smdjeff/pinball-cabin-fever/art/2020/bear.pdf

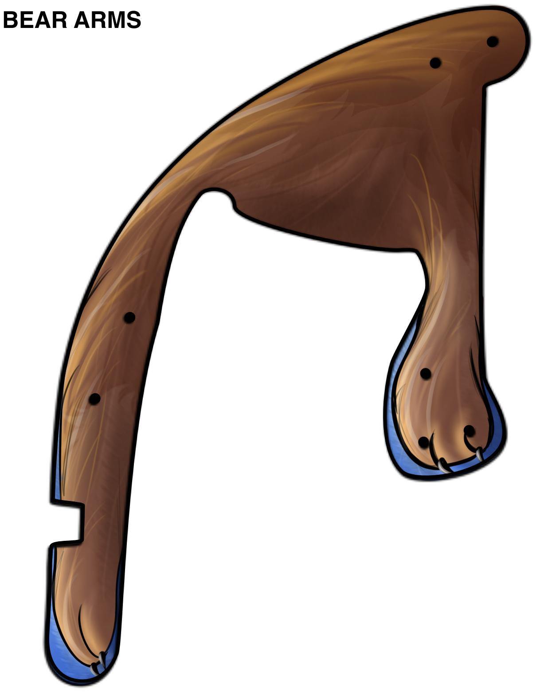
[picture p3: page 1]

BEAR ARMS
