smdjeff/pinball-cabin-fever/art/2020/desert.pdf

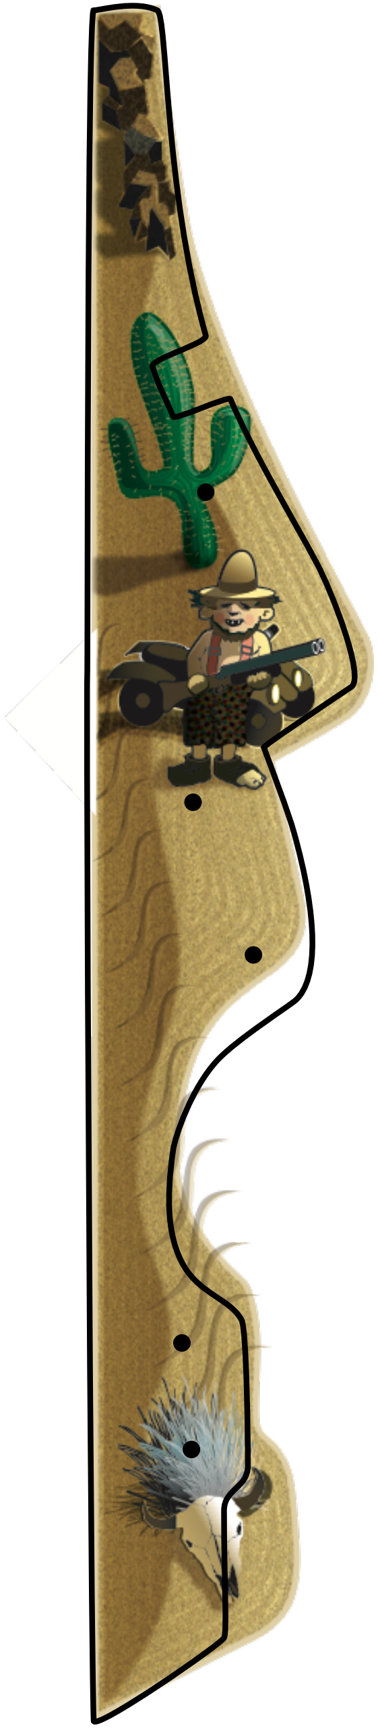
[picture p4: figure]

DESERT
CUTE
CACTUSES
