smdjeff/pinball-cabin-fever/art/2020/forest.pdf

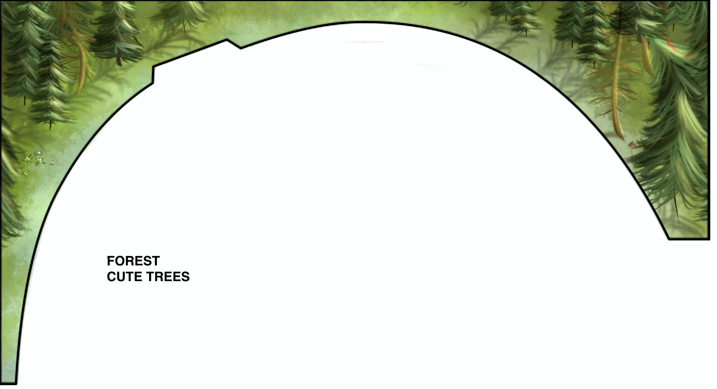
[picture p5: page 1]

FOREST
CUTE TREES
