smdjeff/pinball-cabin-fever/art/2006/bearback.png

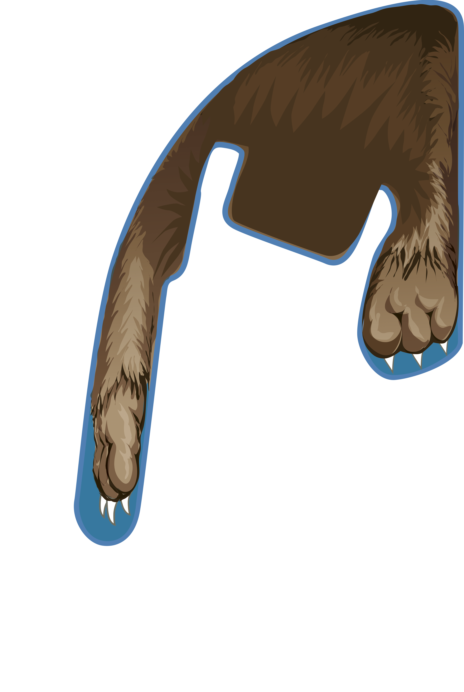
art/2006/bearback.png
