smdjeff/pinball-cabin-fever/art/2006/beavers.png

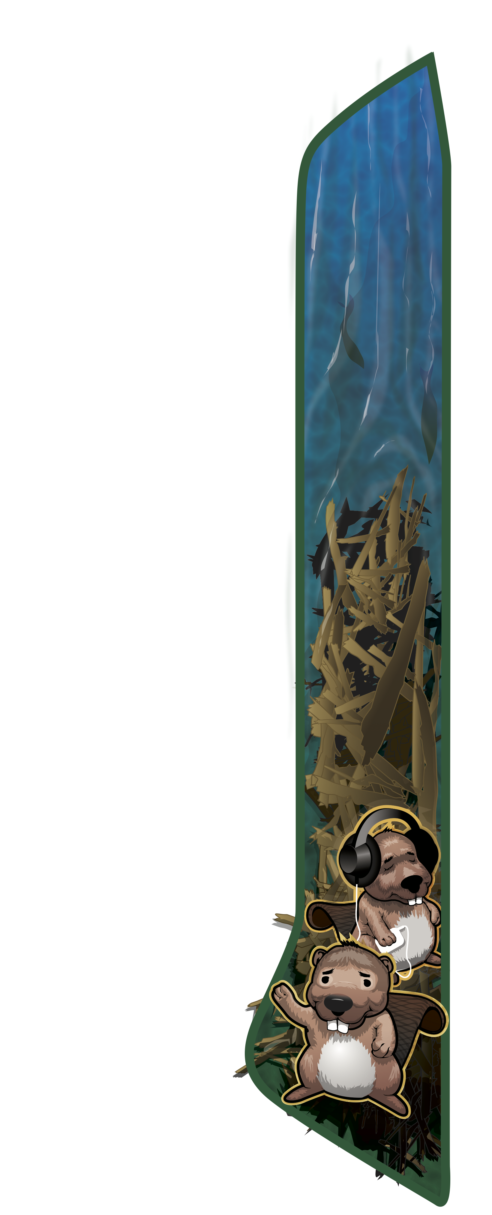
art/2006/beavers.png
