smdjeff/pinball-cabin-fever/art/2006/sling-shot.png

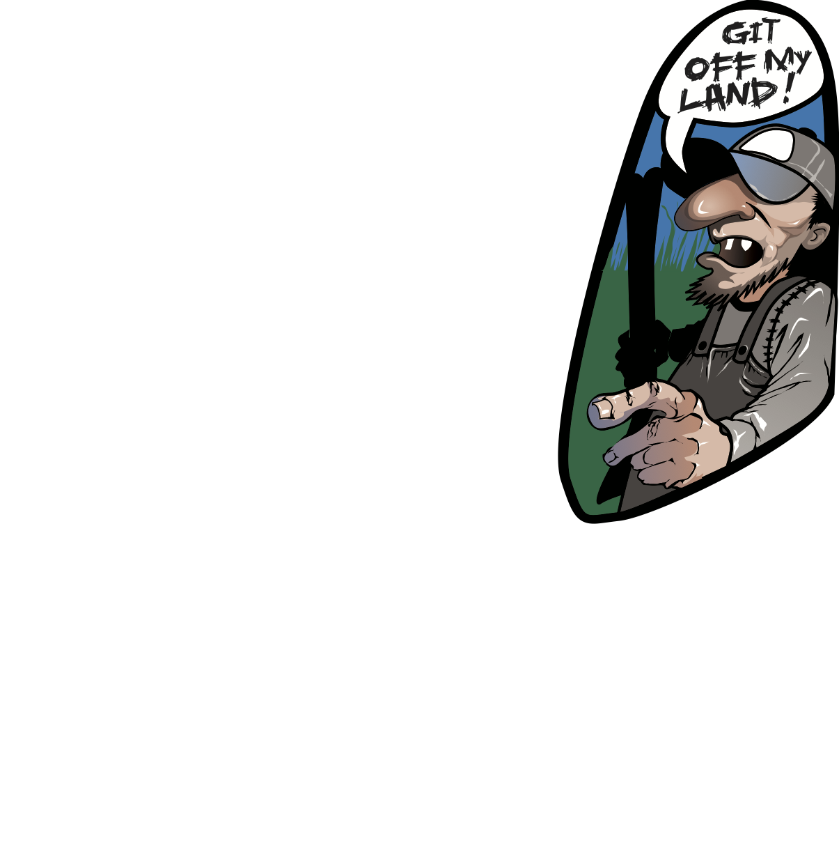
art/2006/sling-shot.png
