smdjeff/pinball-cabin-fever/drawings/P6010001.JPG

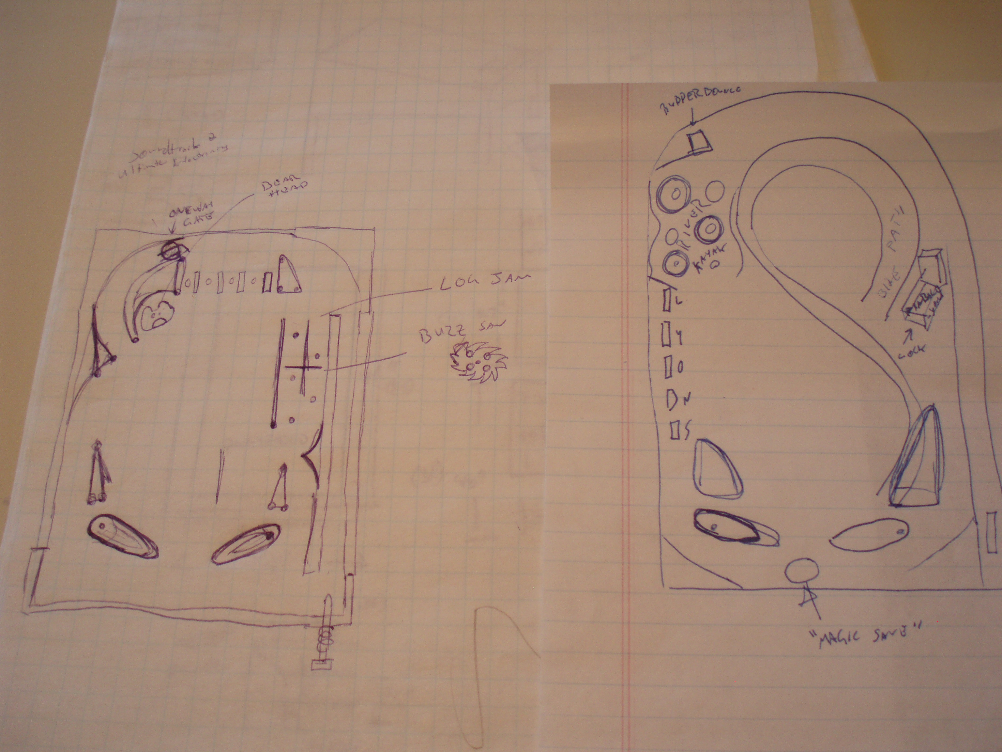
drawings/P6010001.JPG
