smdjeff/pinball-cabin-fever/drawings/P6010002.JPG

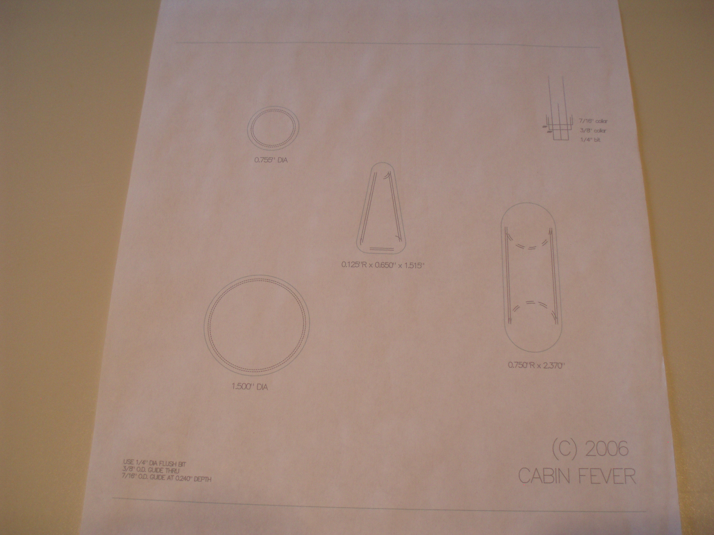
drawings/P6010002.JPG
