smdjeff/pinball-cabin-fever/drawings/P6010003.JPG

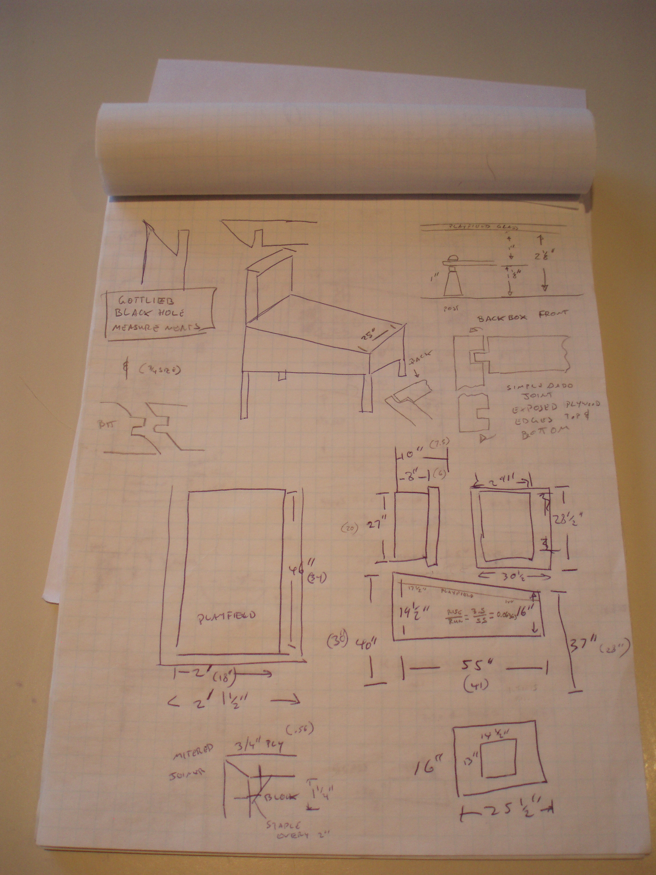
drawings/P6010003.JPG
