smdjeff/pinball-cabin-fever/drawings/P6010004.JPG

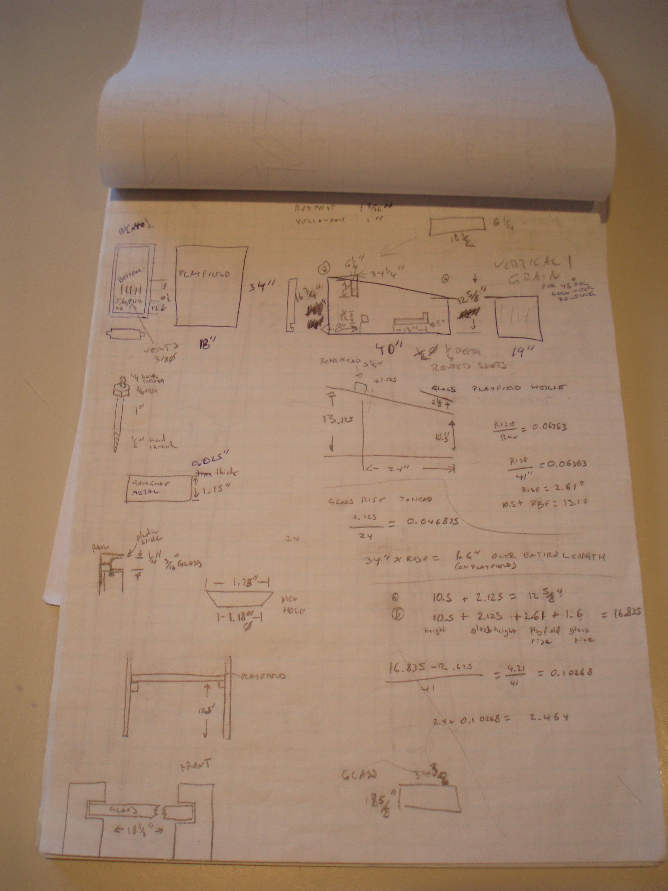
drawings/P6010004.JPG
