smdjeff/pinball-cabin-fever/drawings/P6010005.JPG

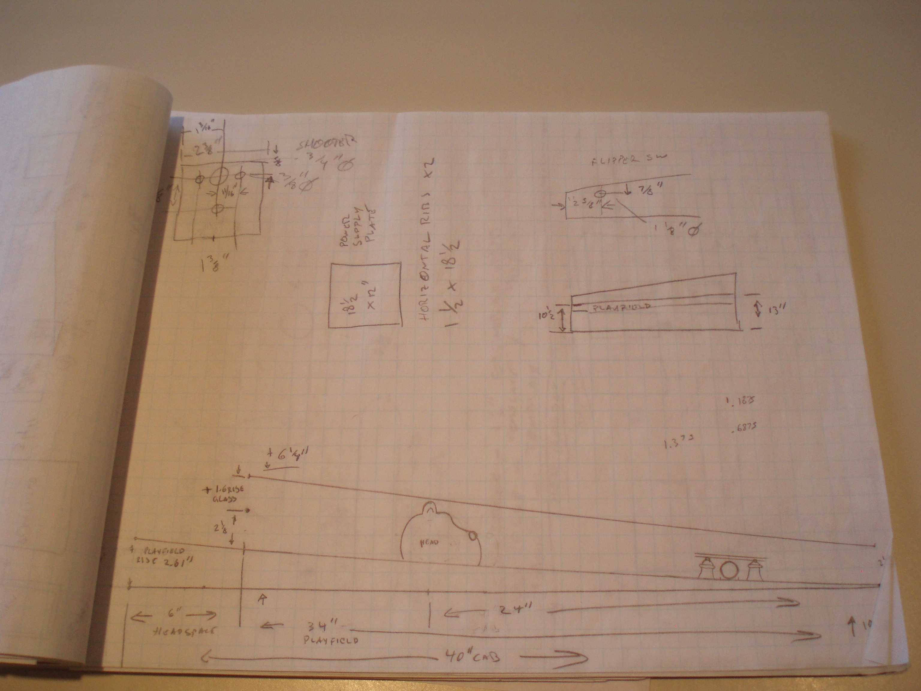
drawings/P6010005.JPG
