smdjeff/pinball-cabin-fever/drawings/P6010006.JPG

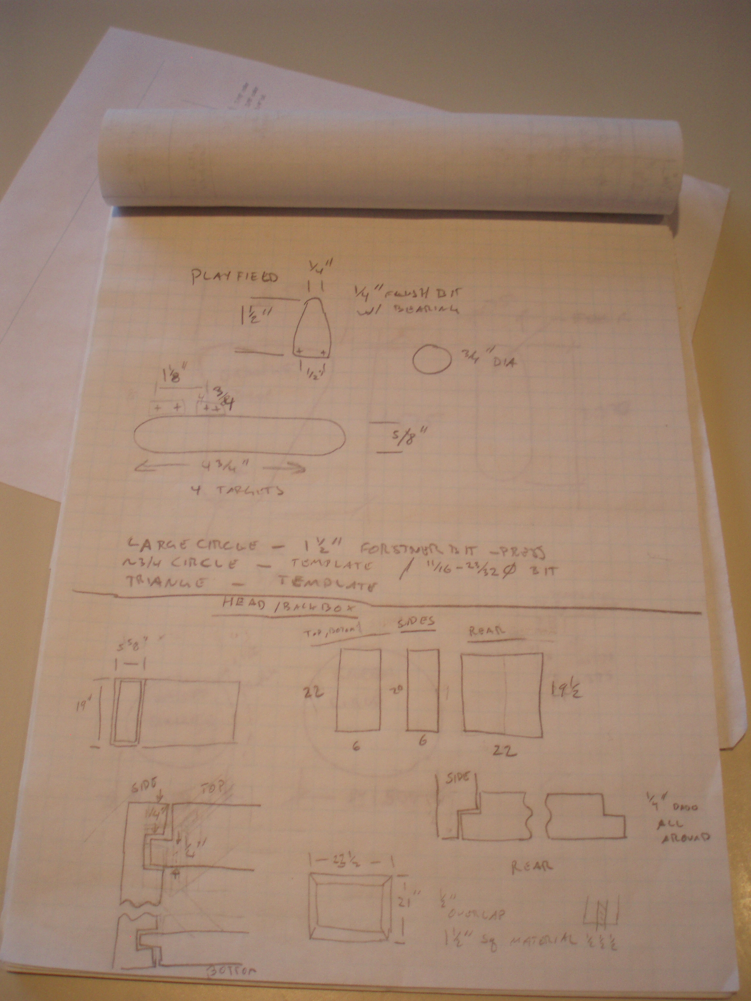
drawings/P6010006.JPG
