smdjeff/pinball-cabin-fever/drawings/P6010007.JPG

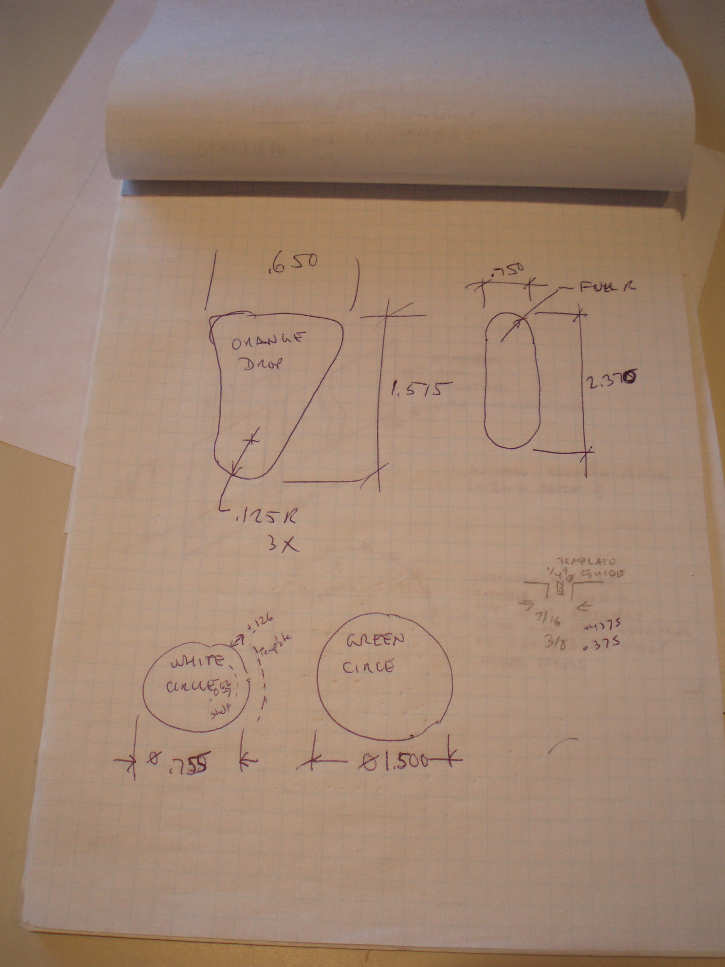
drawings/P6010007.JPG
