smdjeff/pinball-cabin-fever/drawings/P6010008.JPG

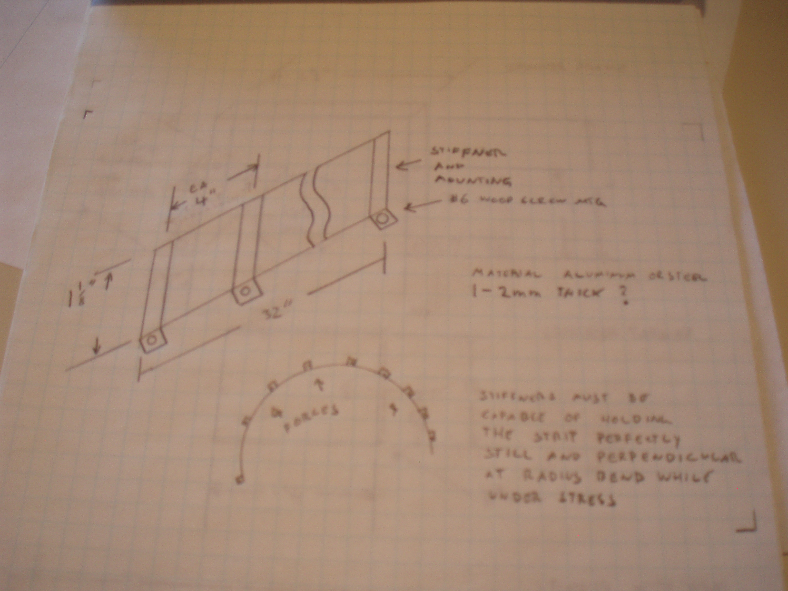
drawings/P6010008.JPG
