smdjeff/pinball-cabin-fever/drawings/P6010009.JPG

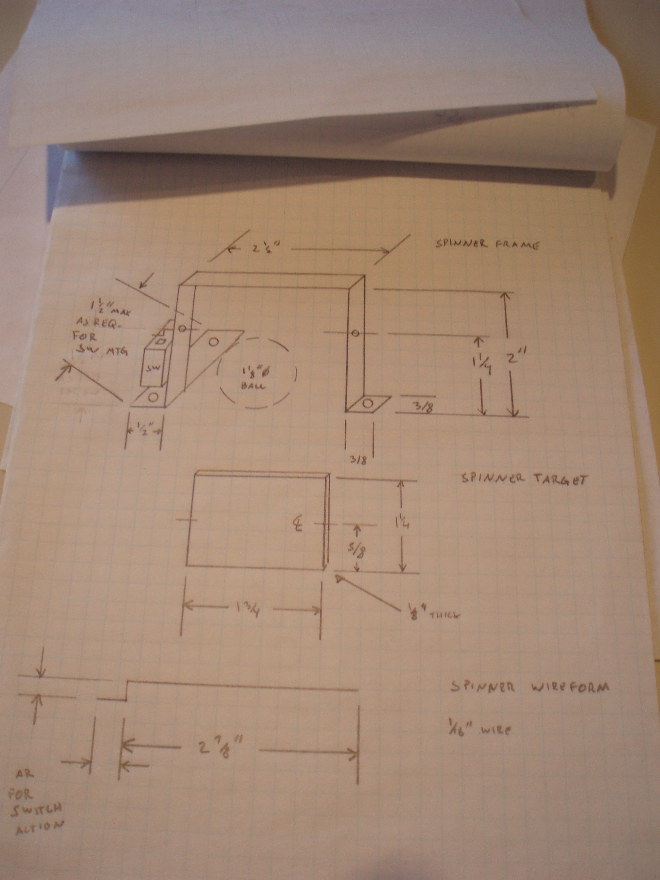
drawings/P6010009.JPG
