smdjeff/pinball-cabin-fever/hardware/PXL_20221127_201824893.jpg

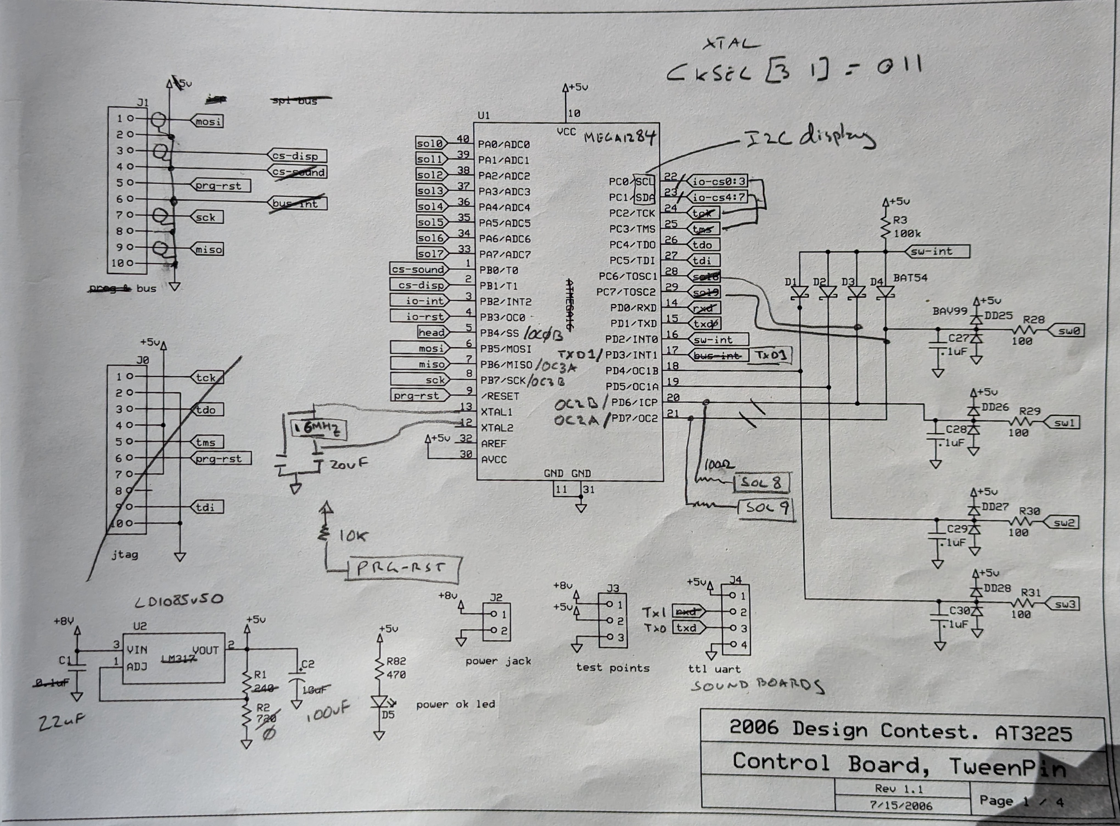
hardware/PXL_20221127_201824893.jpg
