smdjeff/pinball-cabin-fever/(threads)

Thread 2 (2024-12-25):

bug

smdjeff, 2024-12-25:
https://github.com/smdjeff/pinball-cabin-fever/blob/d690e0ed88e16fc53cc86303ee58c6077b1930ee/software/solenoid.c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
