smdjeff/pinball-cabin-fever/hardware/tweenpin-system-diagram.pdf

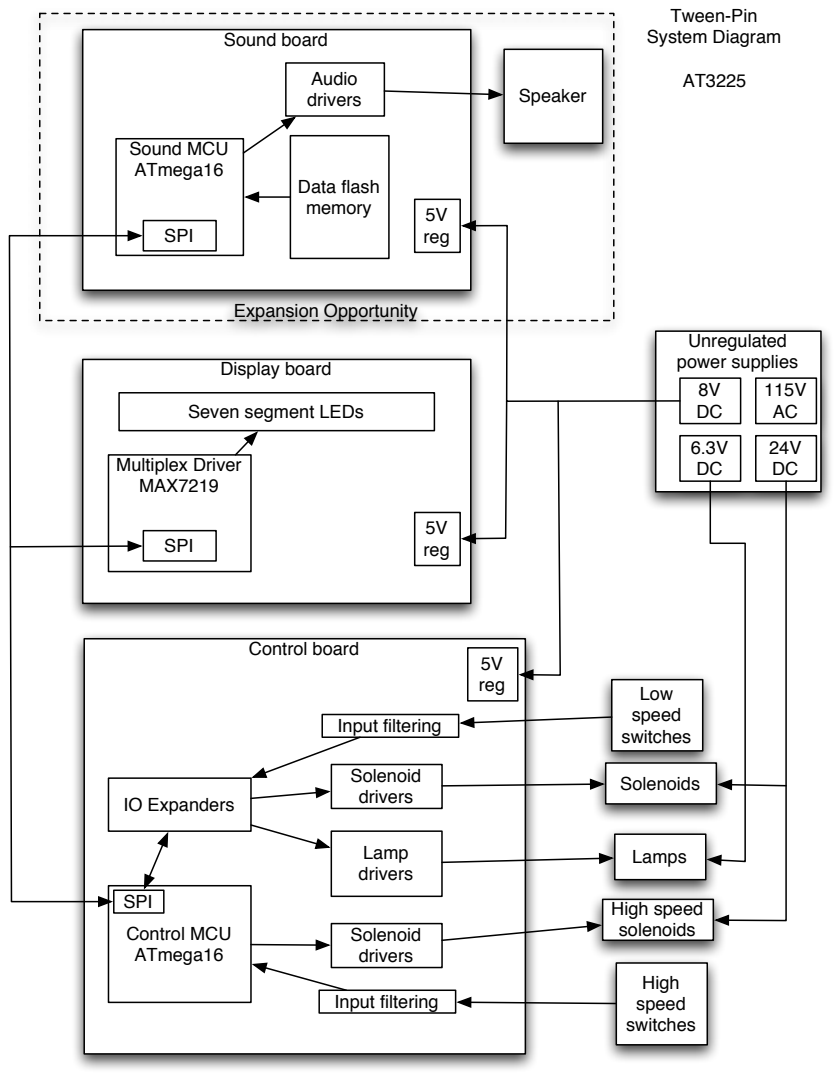
[picture p19: page 1]
Expansion Opportunity; Control board; Unregulated power supplies; Speaker; Solenoids; Lamps; High speed switches; Low speed switches; Sound board; Sound MCU; ATmega16; Data flash; memory; Audio drivers; SPI; 5V reg; Solenoid drivers; Control MCU ATmega16; Lamp drivers; Tween-Pin System Diagram; IO Expanders; Input filtering; High speed; Solenoid; solenoids; drivers; Multiplex Driver MAX7219

Display board

Seven segment LEDs
