smdjeff/pinball-cabin-fever/hardware/tweenpin-control-pcb-bottom.pdf

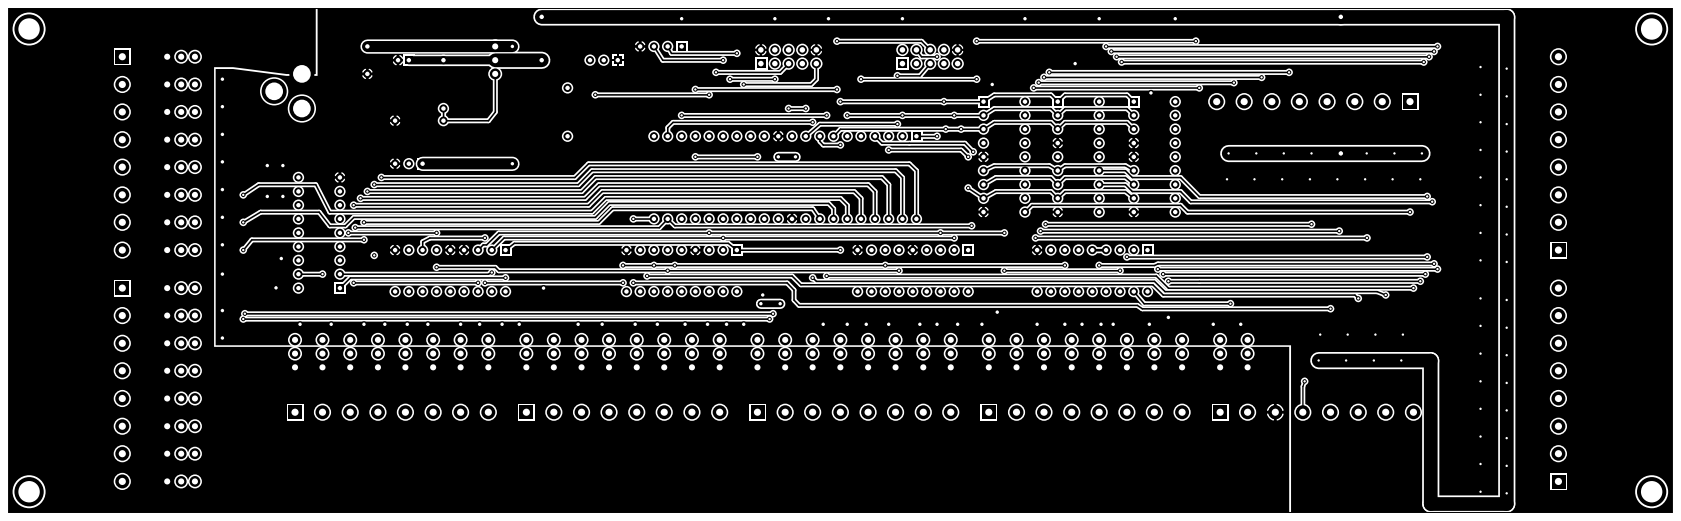
[picture p20: page 1]
