smdjeff/pinball-cabin-fever/hardware/tweenpin-control-pcb-silk.pdf

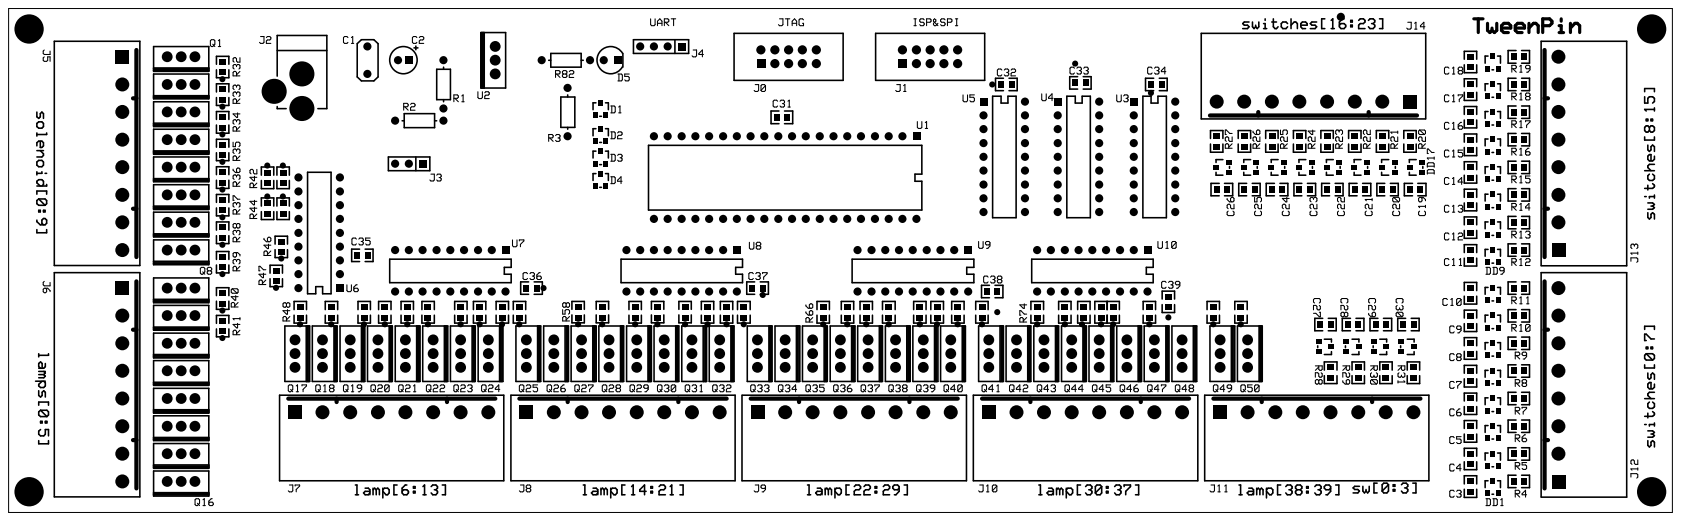
[picture p21: page 1]
