smdjeff/pinball-cabin-fever/hardware/tweenpin-control-pcb-top.pdf

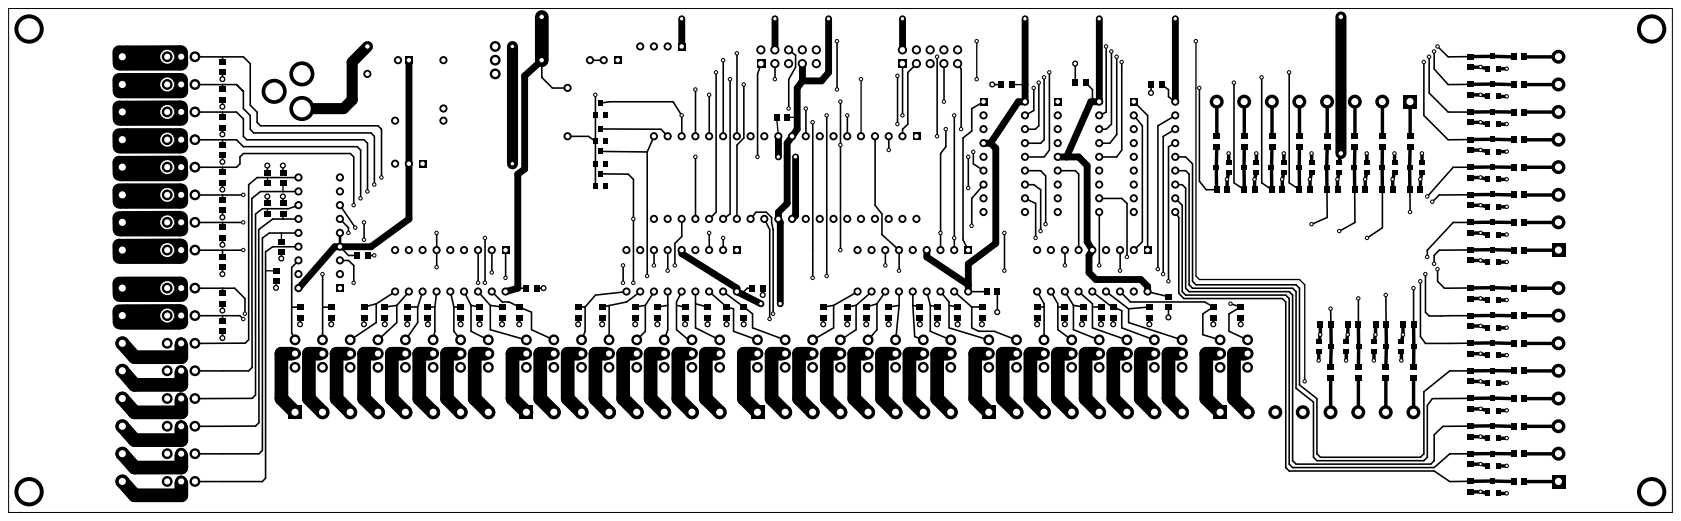
[picture p22: page 1]
