smdjeff/pinball-cabin-fever/hardware/tweenpin-control-sch-1.pdf

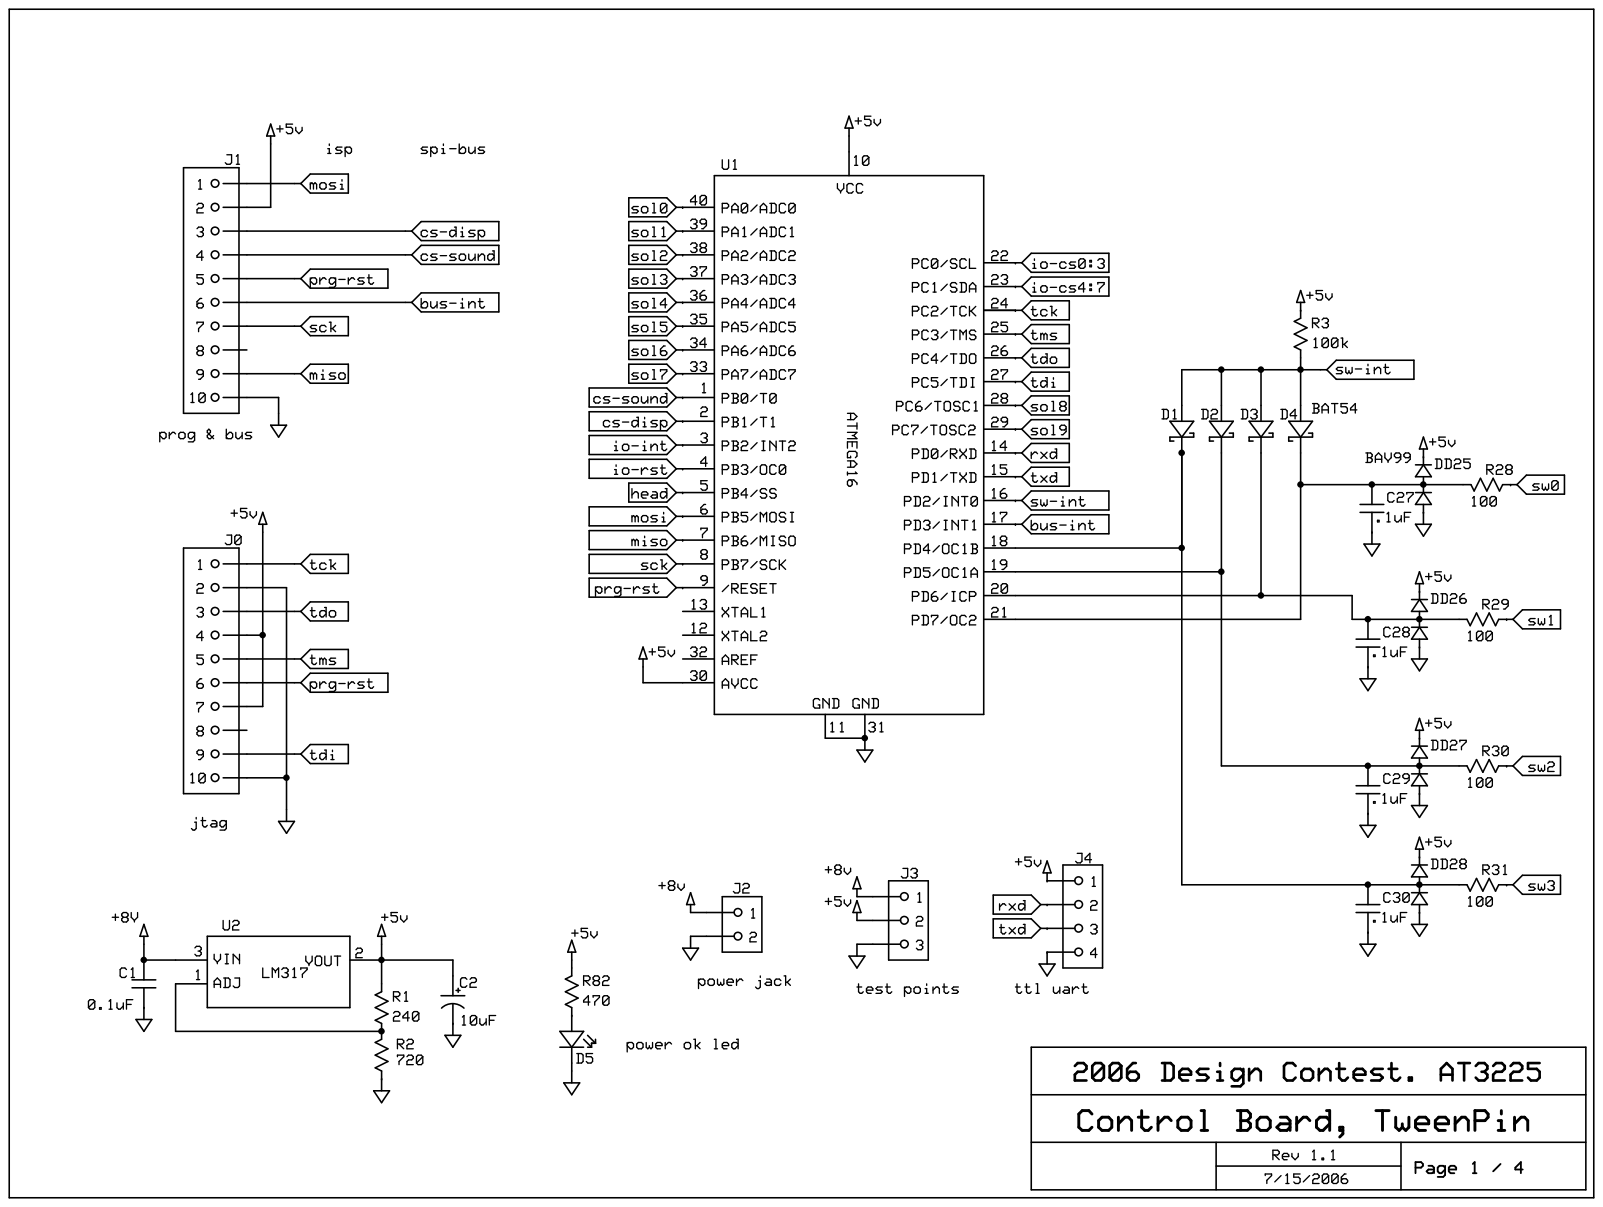
[picture p23: page 1]
