smdjeff/pinball-cabin-fever/hardware/tweenpin-control-sch-2.pdf

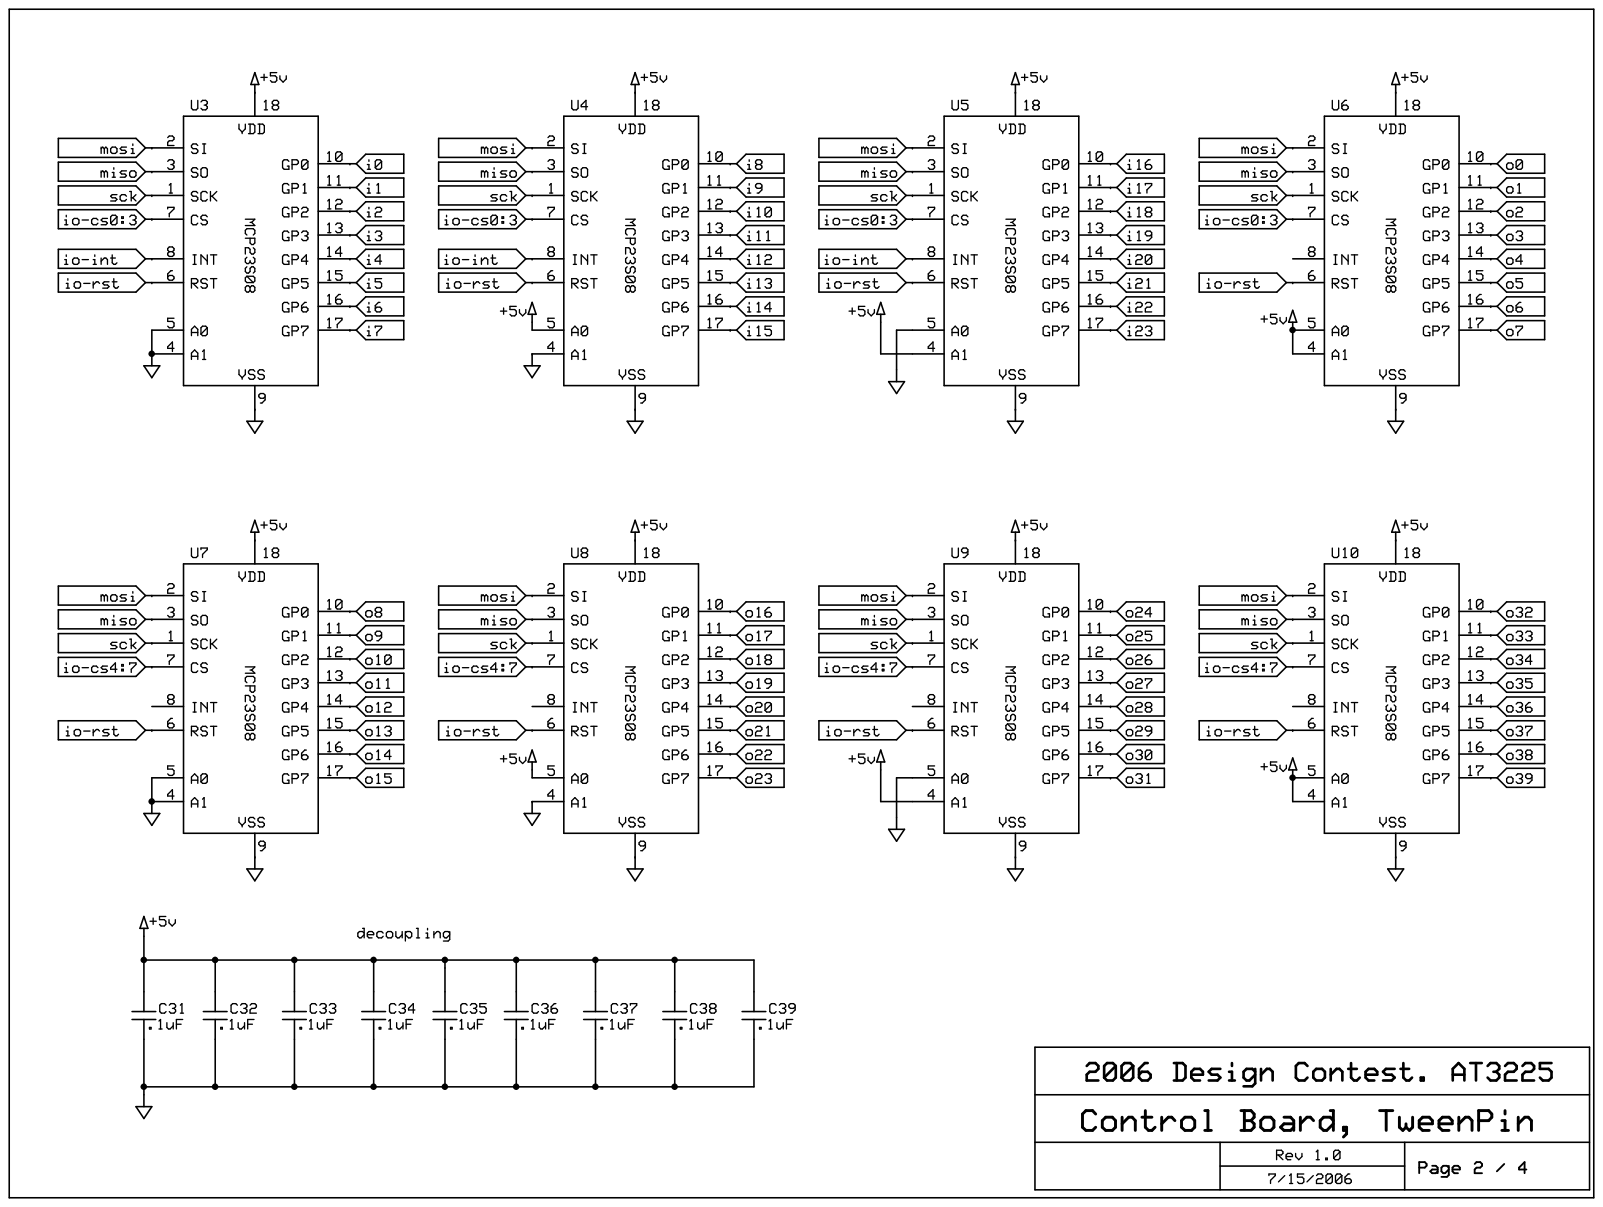
[picture p24: page 1]
