smdjeff/pinball-cabin-fever/hardware/tweenpin-control-sch-3.pdf

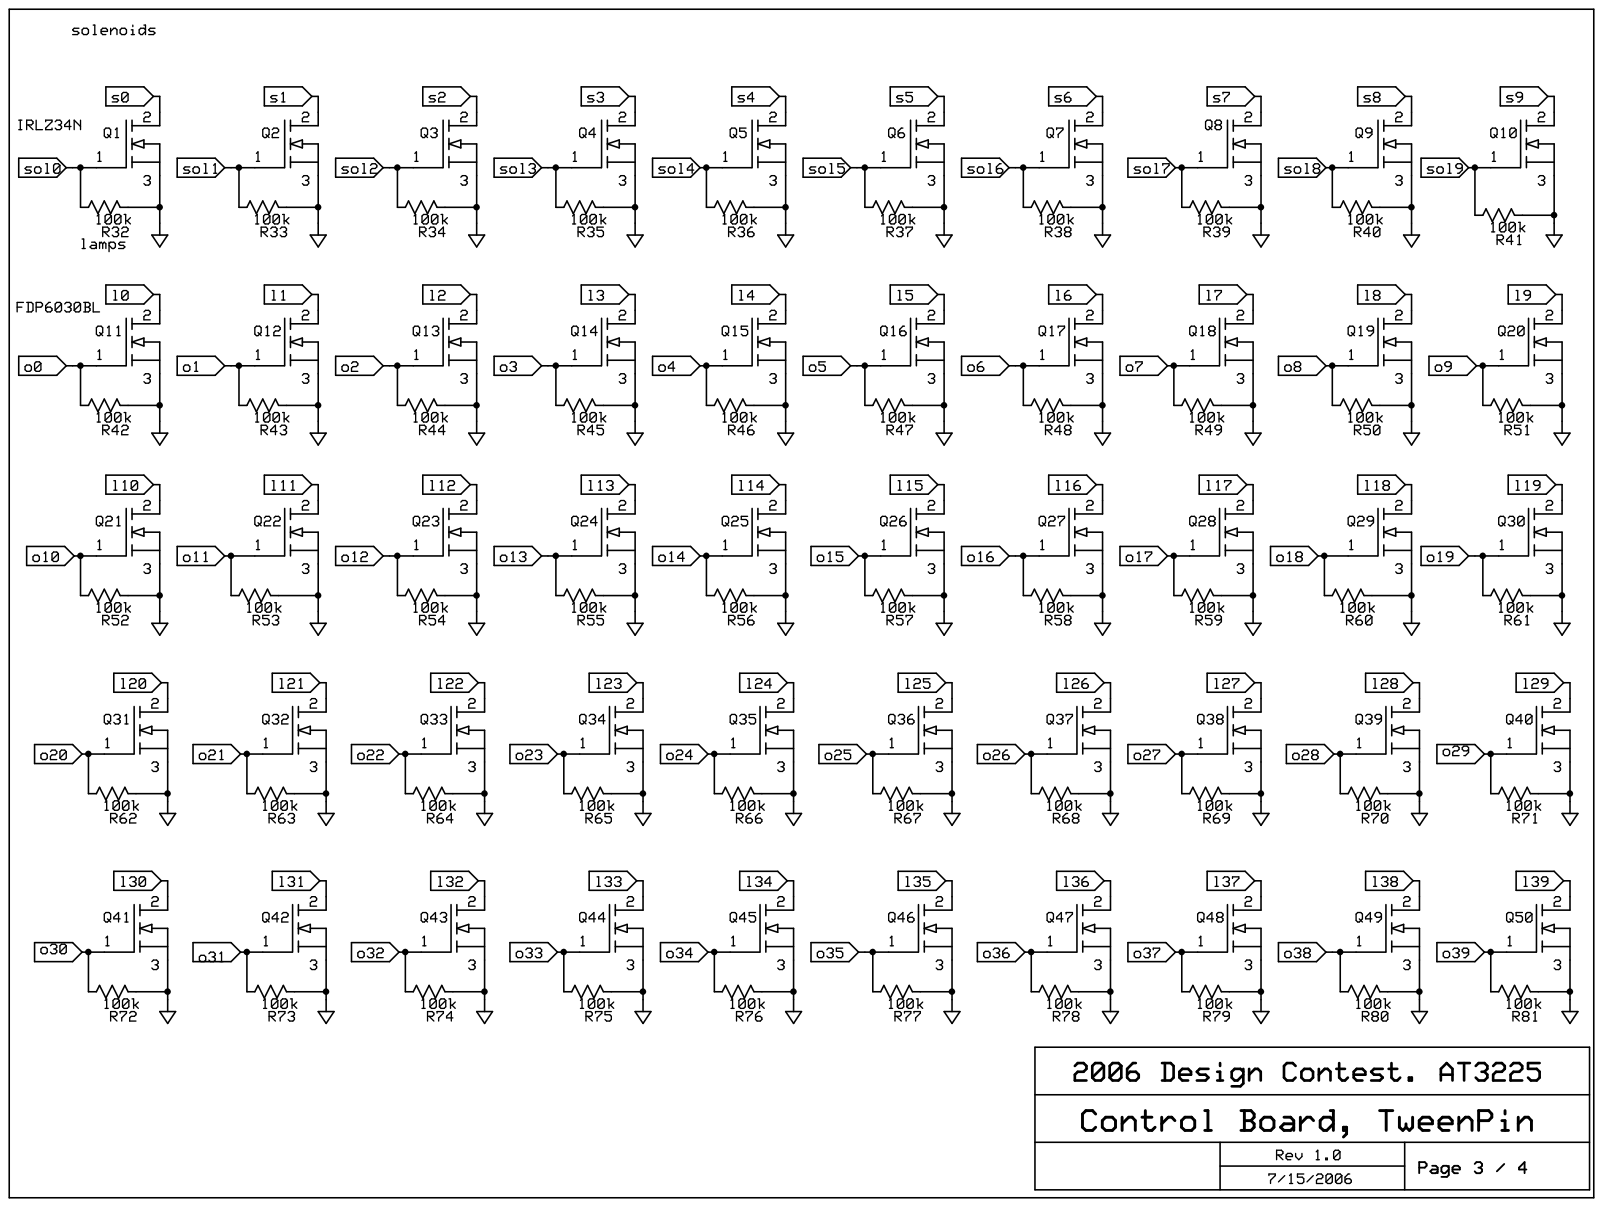
[picture p25: page 1]
