smdjeff/pinball-cabin-fever/hardware/tweenpin-control-sch-4.pdf

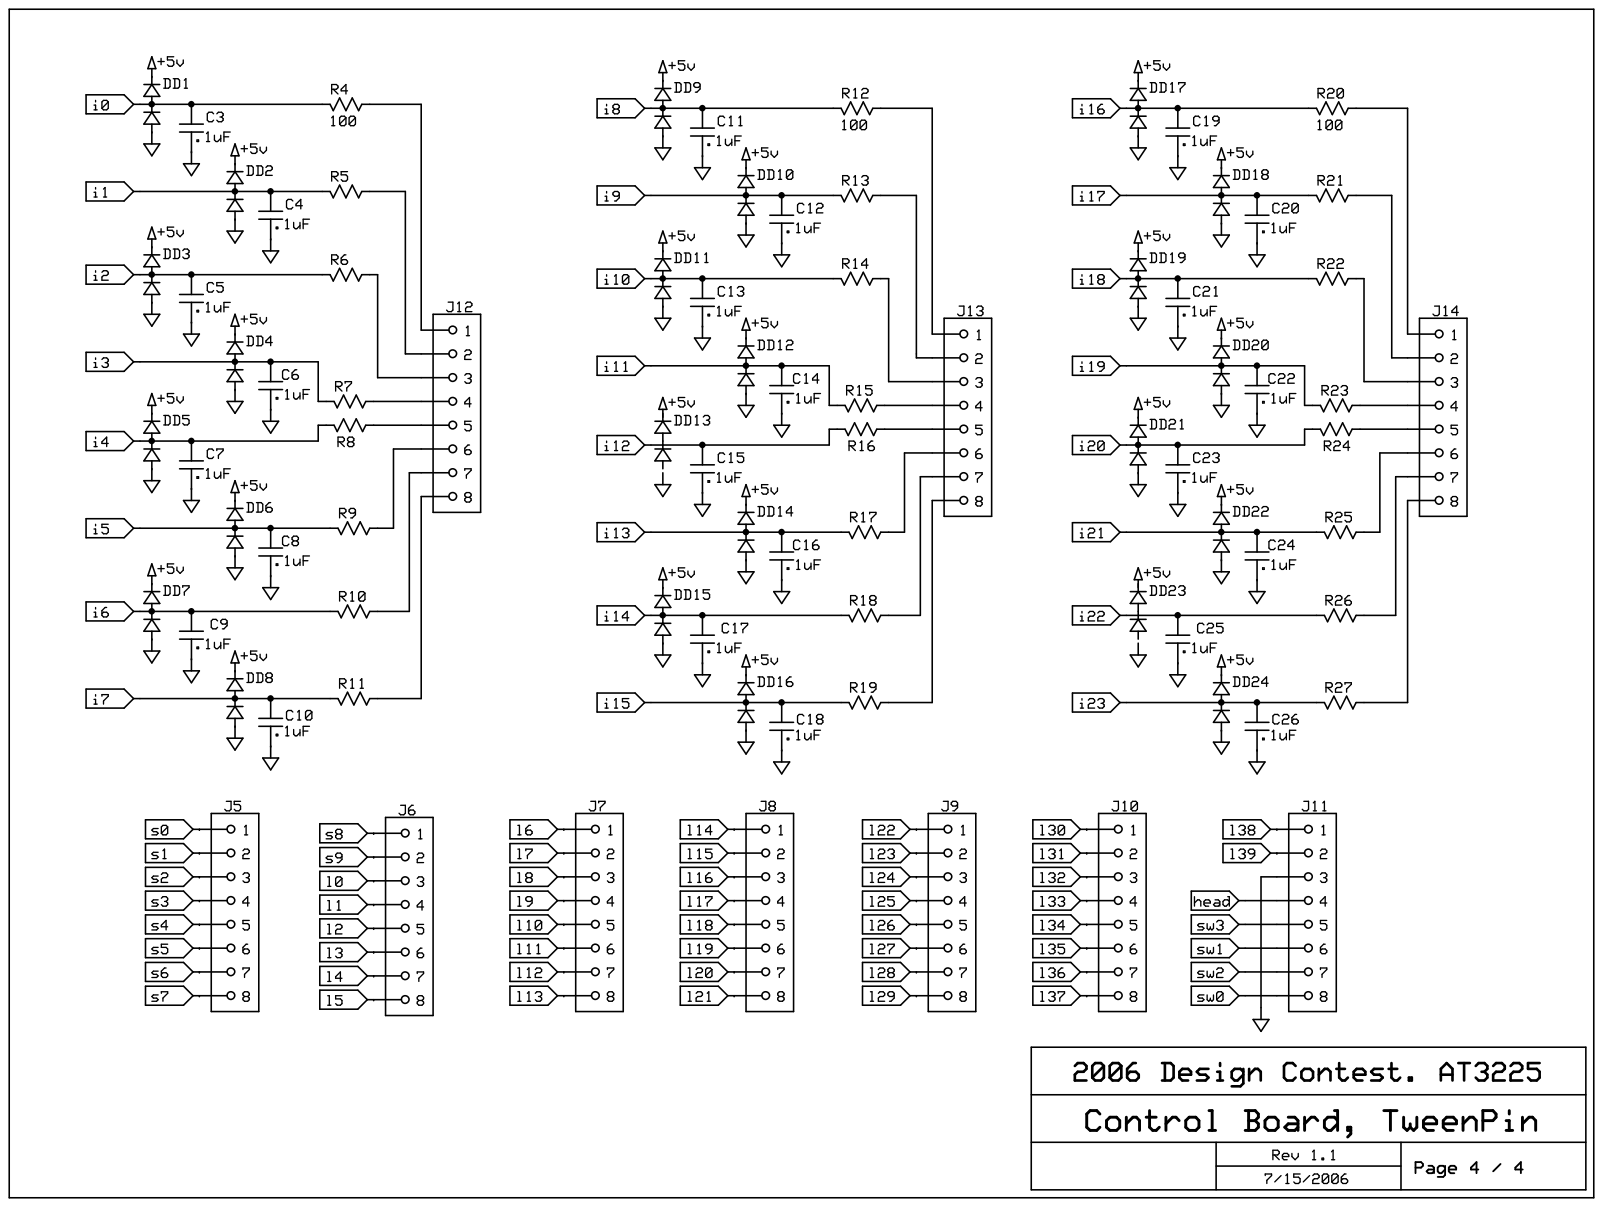
[picture p26: page 1]
