smdjeff/pinball-cabin-fever/hardware/tweenpin-display-pcb-bottom.pdf

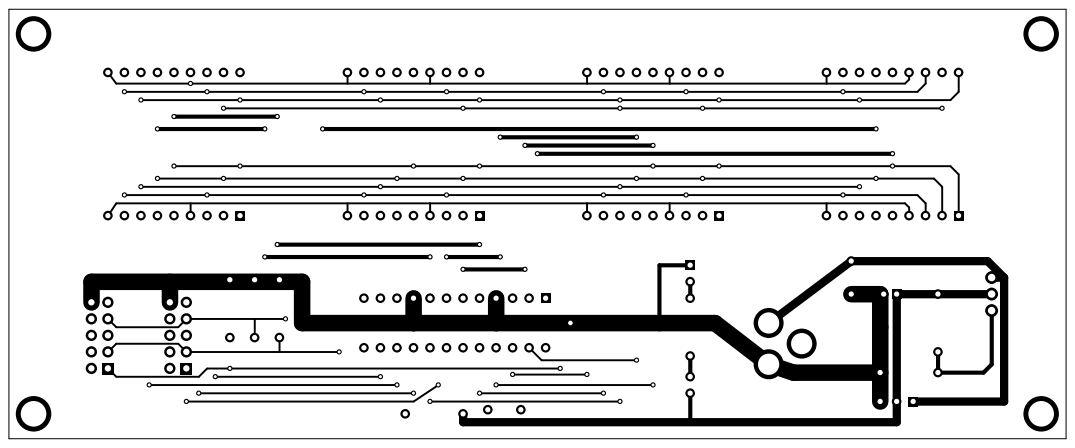
[picture p27: page 1]
