smdjeff/pinball-cabin-fever/hardware/tweenpin-display-pcb-silk.pdf

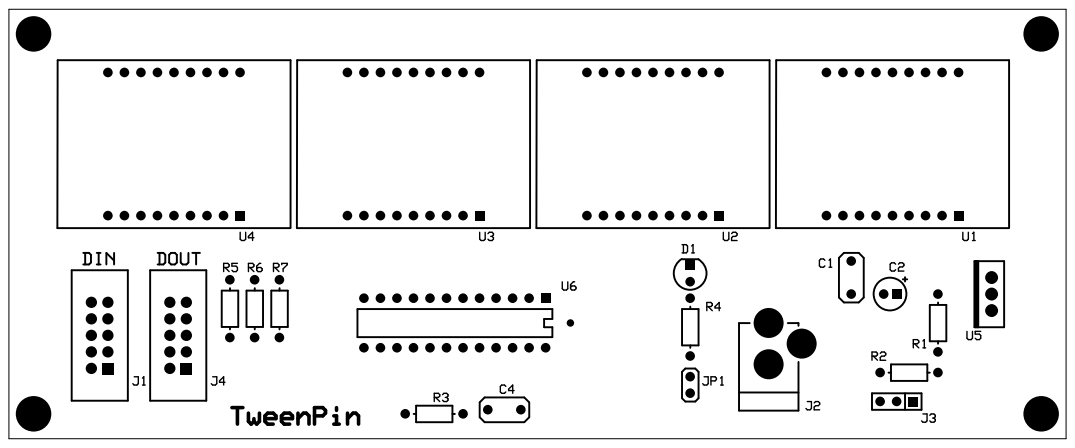
[picture p28: page 1]
