smdjeff/pinball-cabin-fever/hardware/tweenpin-display-pcb-top.pdf

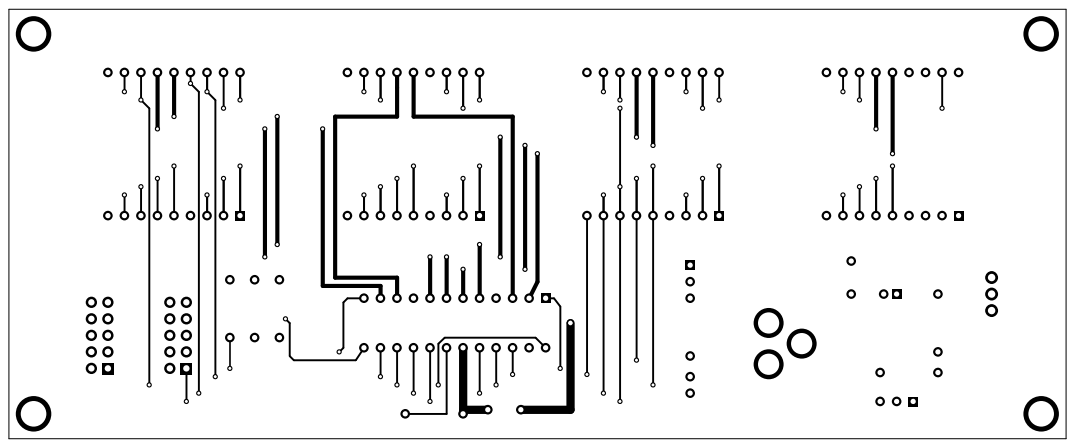
[picture p29: page 1]
