smdjeff/pinball-cabin-fever/hardware/tweenpin-display-sch.pdf

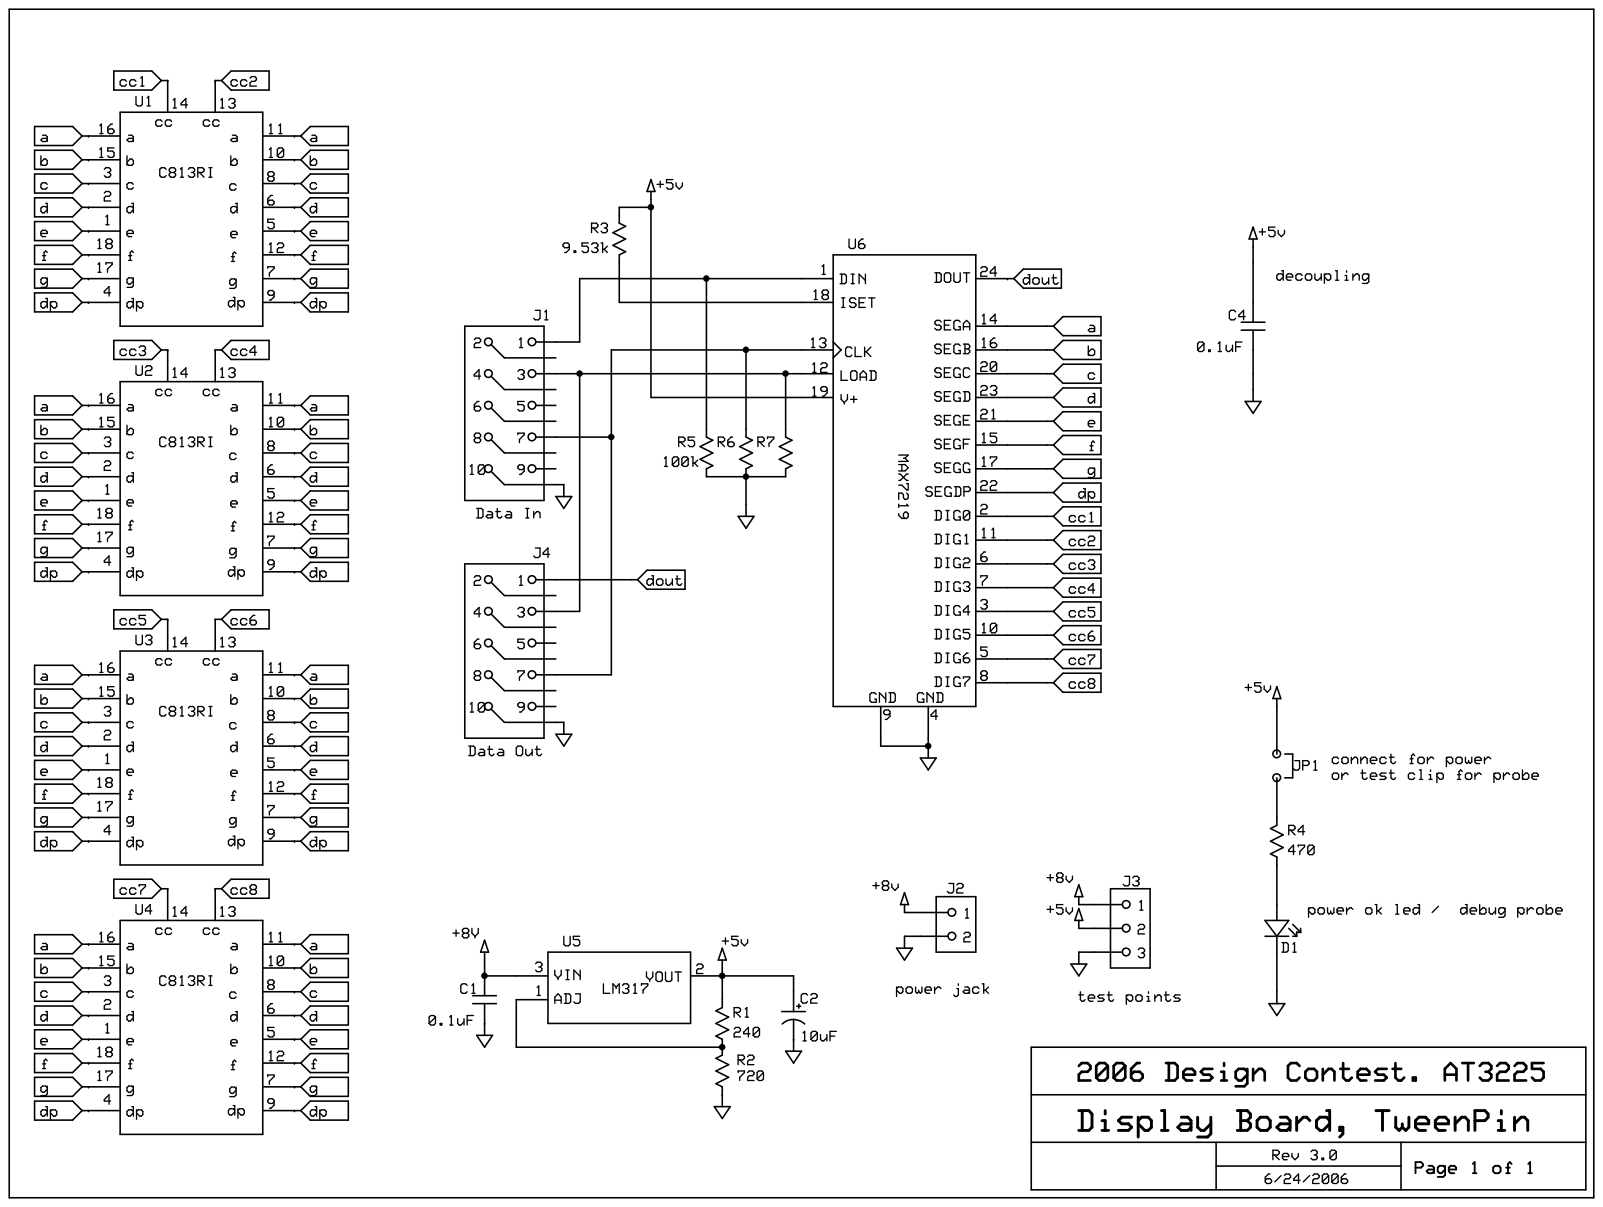
[picture p30: page 1]
