smdjeff/pinball-cabin-fever/hardware/tweenpin-machine-sch-1.pdf

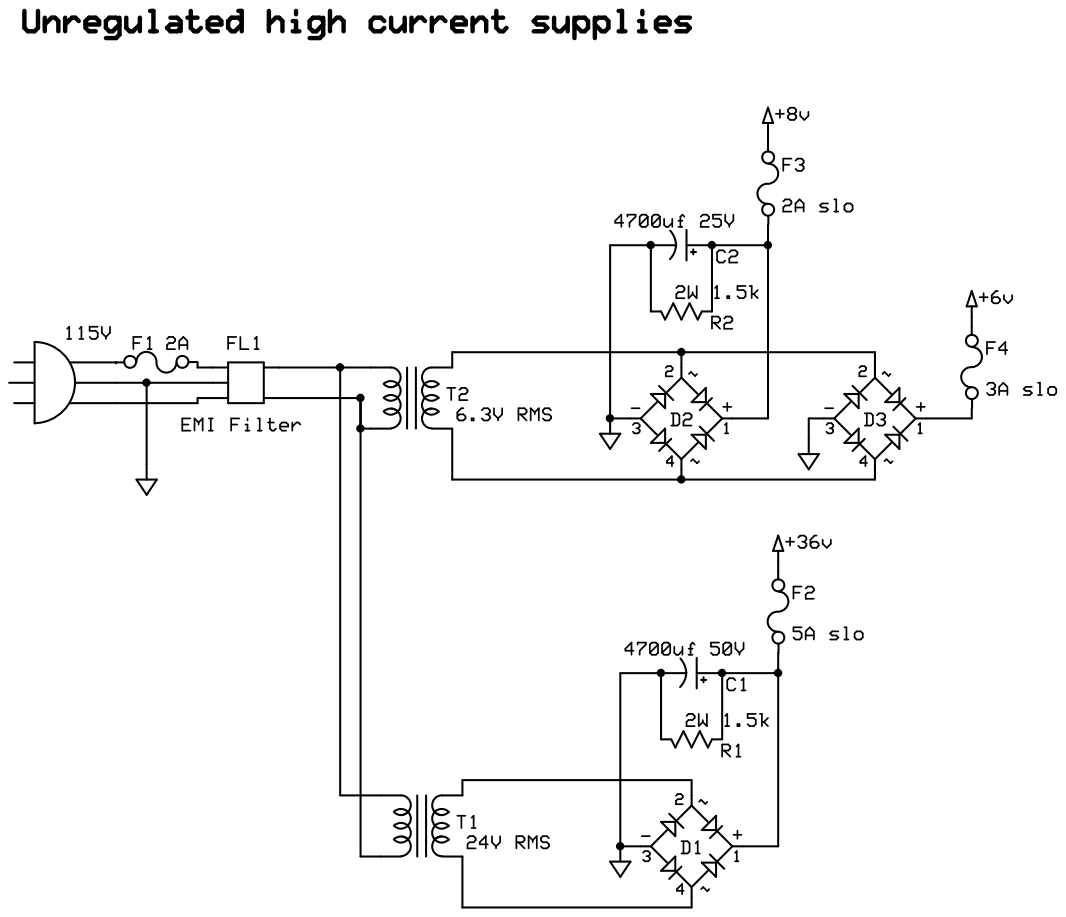
[picture p31: page 1]
