smdjeff/pinball-cabin-fever/hardware/tweenpin-machine-sch-2.pdf

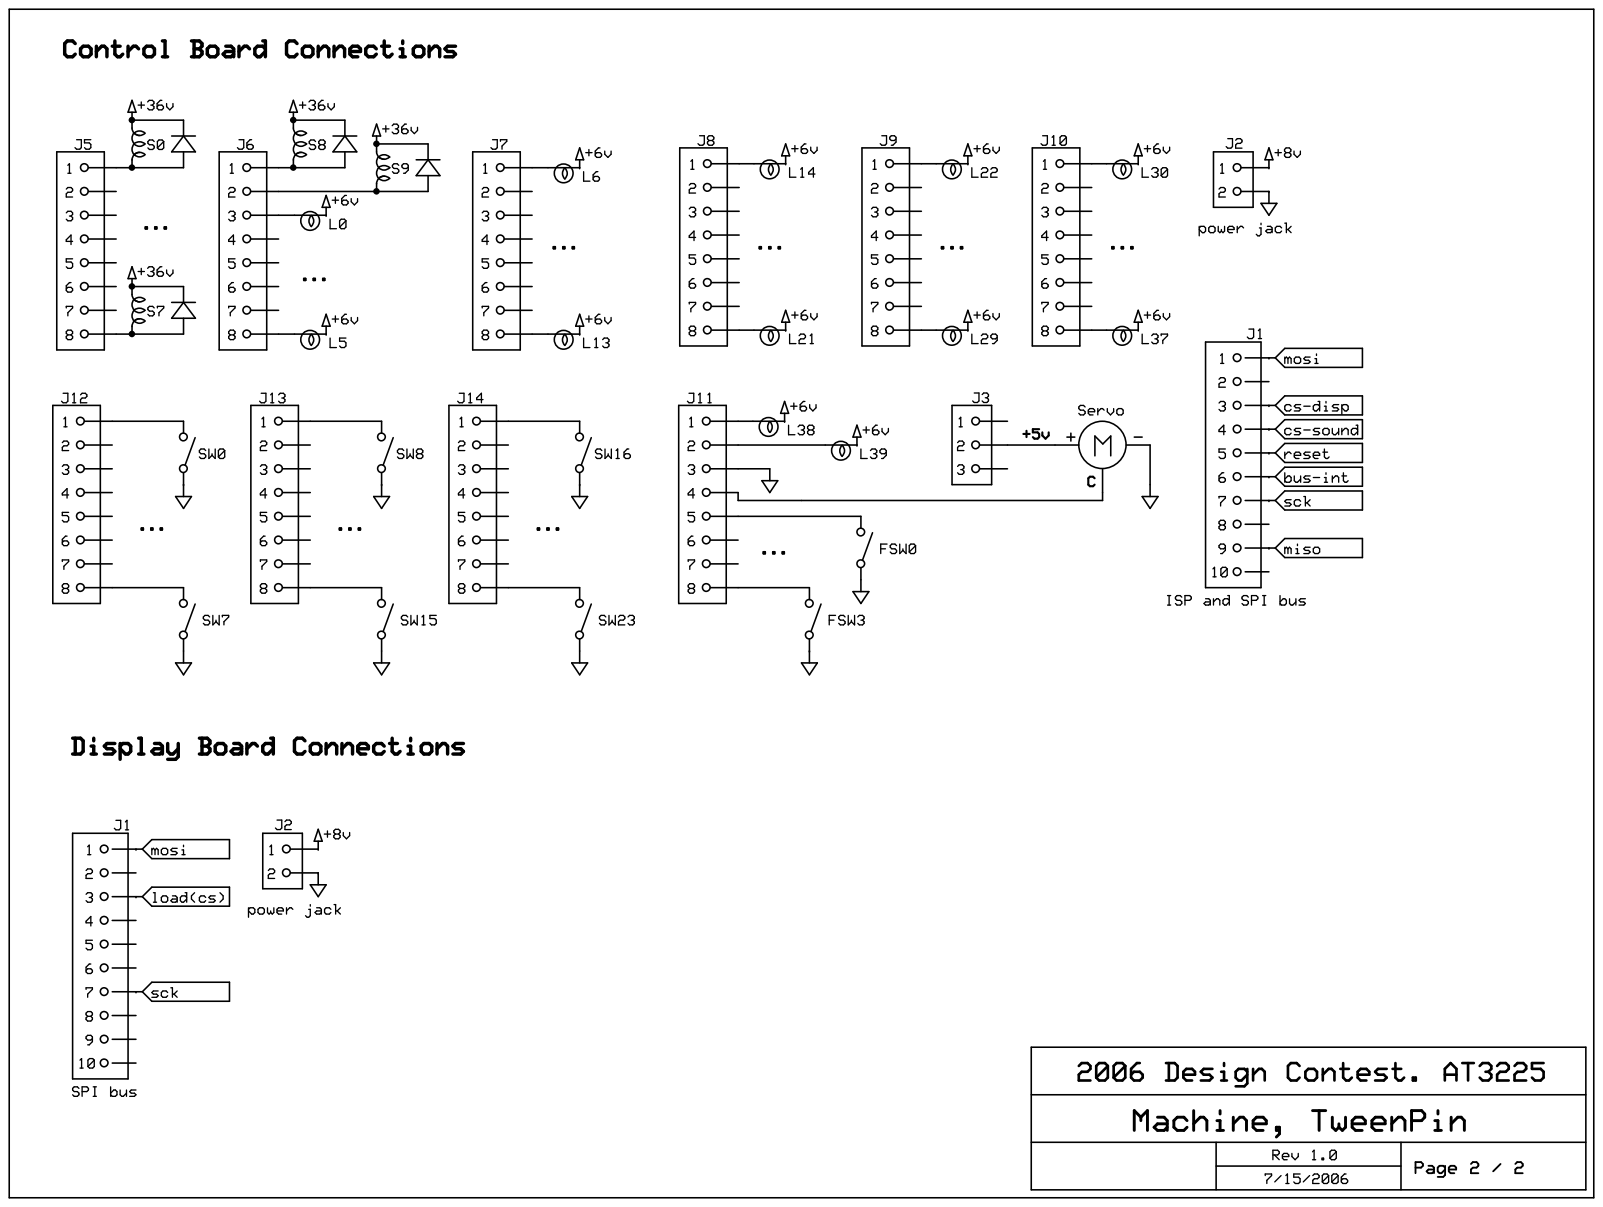
[picture p32: page 1]
