smdjeff/pinball-cabin-fever/art/2020/beavers.pdf

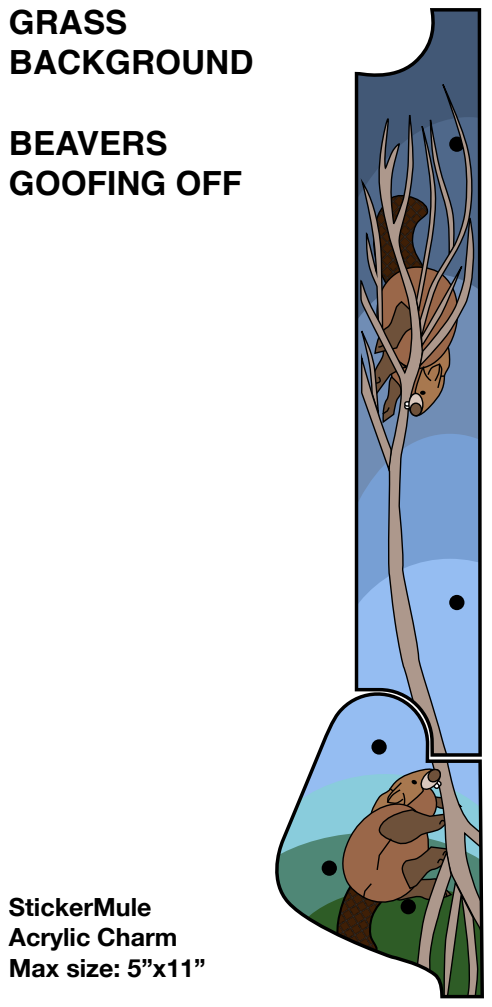
[picture p33: page 1]
GRASS BACKGROUND; BEAVERS GOOFING OFF; StickerMule Acrylic Charm Max size: 5”x11”
