smdjeff/pinball-cabin-fever/art/2025/bear.pdf

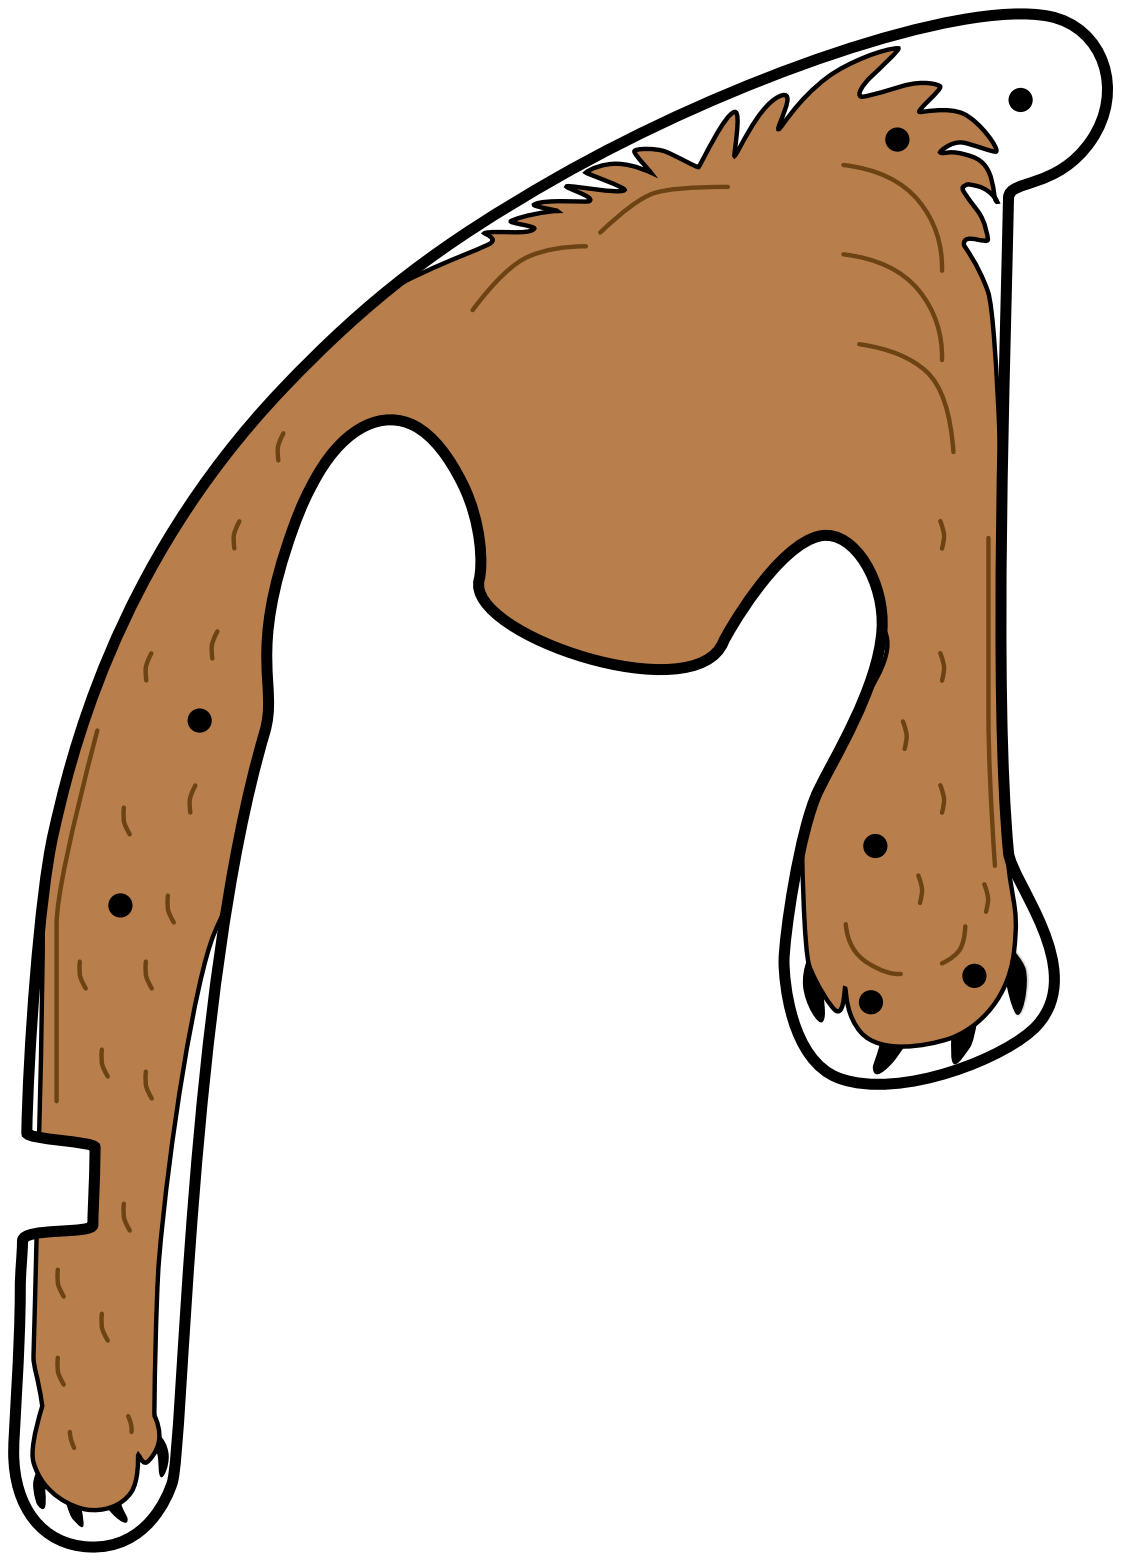
[picture p34: page 1]
