smdjeff/pinball-cabin-fever/art/2025/beavers.pdf

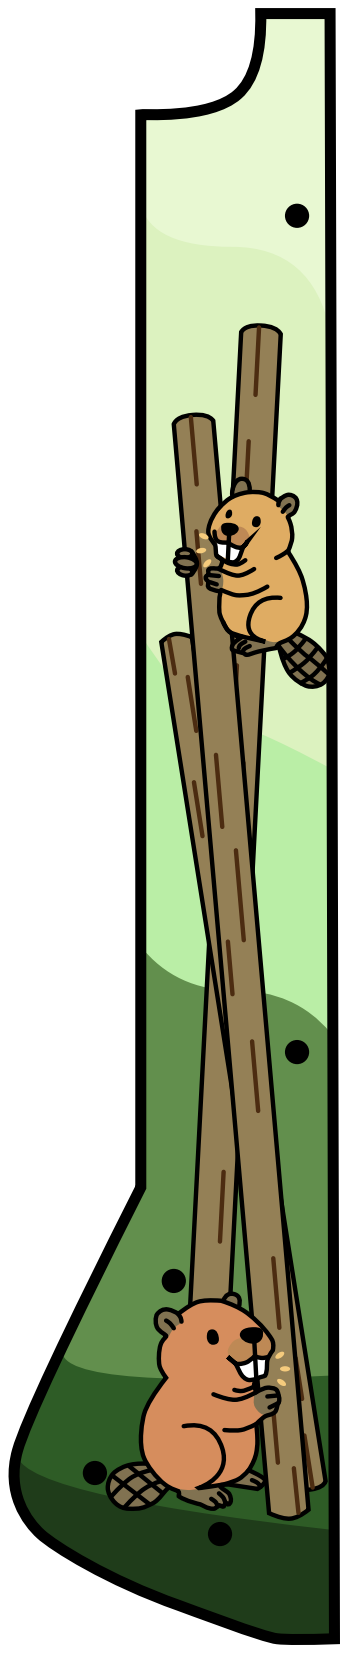
[picture p35: page 1]
