smdjeff/pinball-cabin-fever/art/2025/bigloop.pdf

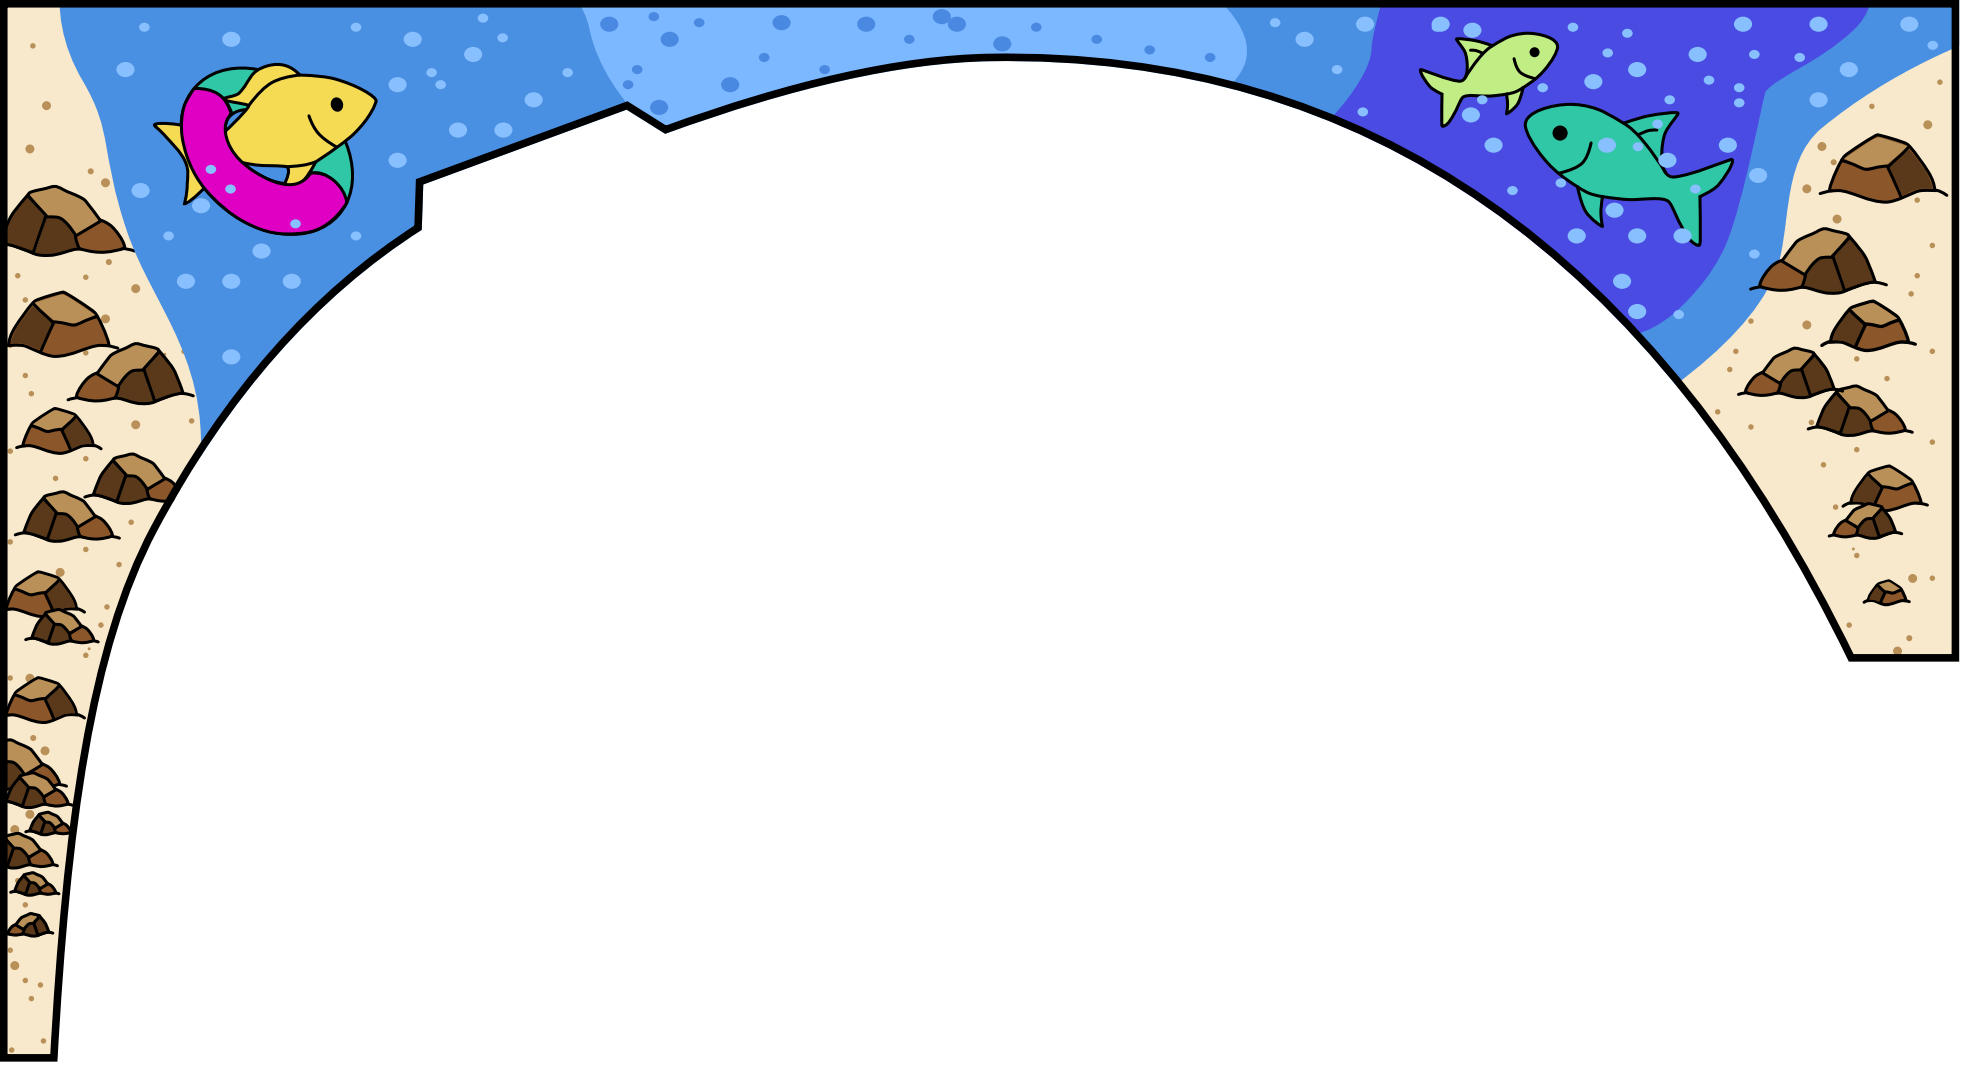
[picture p36: page 1]
