smdjeff/pinball-cabin-fever/art/2025/desert.pdf

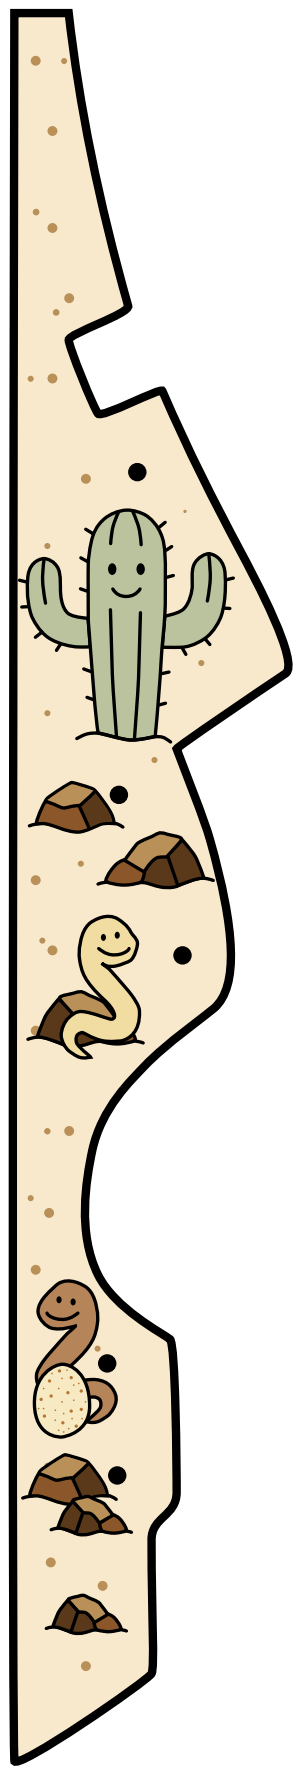
[picture p37: page 1]
