smdjeff/pinball-cabin-fever/software/tweenpin.c

///////////////////////////////////////////////////////////////////////////////
//
// (c)2006  diypinball.com
//
///////////////////////////////////////////////////////////////////////////////

#include <stdlib.h>
#include <string.h>

#include "tweenpin.h"


uint8_t ballInPlay = 0;
boolean tilt = FALSE;
uint8_t tiltSense = 0;
uint8_t multiplier = 1;
boolean gameOn = FALSE;
boolean highScoreExceeded = FALSE;
boolean scoreDisplayDisabled = FALSE;
boolean ballIsLoading = FALSE;
boolean crazyMode = FALSE;

static uint32_t score = 0;
static uint8_t credits = 0;
nonVolatiles_t nonVolatiles = {0,};


int main (void)
{  
  wdt_reset();
  wdt_enable(WDTO_1S);
  
  initIO();
  initSolenoids();
  flipperInitPulse();
  bearInitPulse();
  initFastSwitches();
  initDisplay();
  initSound();
  
  loadNonVolatiles();
  
  initTimers();
  setTimer(WATCHDOG_TMR, ONE_SECOND, 0);
  sei();
  
  gameOver();

  for (;; )
  {
    // the only things done in interrupt context are incremeting the system tick
    // and the sound uart tx fifo. this increases reliability and makes the 
    // system more deterministic. it also reduces the ATOMIC_BLOCK() clutter 

    driveLamps();
    driveSlowSwitches();
    driveFastSwitches();
    driveSolenoids();
    driveTimers();
  }
}

void watchdogTimer(timerEvent id, uint16_t data) {
  static uint16_t check = ~0;
  if ( check == ~data ) {
    wdt_reset();
    data++;
    check = ~data;
    setTimer(WATCHDOG_TMR, HALF_SECOND, data);
  }
}

const uint8_t vertLamps[15][3] PROGMEM = {
  {
    LAMP_RIVER_ARROW_6,
    LAMP_TARGET_1_B,
    LAMP_TARGET_1_B,
  },
  {
    LAMP_RIVER_ARROW_6,
    LAMP_TARGET_1_E,
    LAMP_TARGET_1_E,
  },
  {
    LAMP_RIVER_ARROW_5,
    LAMP_TARGET_1_A,
    LAMP_TARGET_1_A,
  },
  {
    LAMP_RIVER_ARROW_5,
    LAMP_TARGET_1_R,
    LAMP_TARGET_1_R,
  },
  {
    LAMP_RIVER_ARROW_4,
    LAMP_BEAR_MOUTH,
    LAMP_TARGET_2_L,
  },
  {
    LAMP_RIVER_ARROW_3,
    LAMP_TARGET_2_O,
    LAMP_TARGET_2_O,
  },
  {
    LAMP_RIVER_ARROW_3,
    LAMP_BEAR_ARROW,
    LAMP_TARGET_2_G,
  },
  {
    LAMP_RIVER_ARROW_2,
    LAMP_TARGET_2_J,
    LAMP_TARGET_2_J,
  },
  {
    LAMP_RIVER_ARROW_2,
    LAMP_TARGET_2_A,
    LAMP_TARGET_2_A,
  },
  {
    LAMP_RIVER_ARROW_1,
    LAMP_TARGET_2_M,
    LAMP_TARGET_2_M,
  },
  {
    LAMP_TARGET_UPPER,
    LAMP_BONUS_1,
    LAMP_BONUS_1,
  },
  {
    LAMP_BONUS_2,
    LAMP_BONUS_3,
    LAMP_BONUS_3,
  },
  {
    LAMP_BONUS_4,
    LAMP_BONUS_5,
    LAMP_BONUS_6,
  },
  {
    LAMP_LANE_LEFT,
    LAMP_LANE_RIGHT,
    LAMP_LANE_RIGHT,
  },
  {
    LAMP_TARGET_LOWER,
    LAMP_LANE_LEFT,
    LAMP_LANE_RIGHT,
  }
};

const uint8_t horizLamps[11][6] PROGMEM = {
  {
    LAMP_RIVER_ARROW_4,
    LAMP_RIVER_ARROW_3,
    LAMP_TARGET_LOWER,
    LAMP_TARGET_UPPER,
    LAMP_TARGET_UPPER,
    LAMP_TARGET_UPPER,
  },
  {
    LAMP_RIVER_ARROW_5,
    LAMP_RIVER_ARROW_2,
    LAMP_RIVER_ARROW_2,
    LAMP_RIVER_ARROW_2,
    LAMP_RIVER_ARROW_2,
    LAMP_RIVER_ARROW_2,
  },
  {
    LAMP_RIVER_ARROW_6,
    LAMP_RIVER_ARROW_1,
    LAMP_RIVER_ARROW_1,
    LAMP_RIVER_ARROW_1,
    LAMP_RIVER_ARROW_1,
    LAMP_RIVER_ARROW_1,
  },
  {
    LAMP_BEAR_MOUTH,
    LAMP_BEAR_ARROW,
    LAMP_BONUS_4,
    LAMP_TARGET_1_B,
    LAMP_TARGET_1_B,
    LAMP_TARGET_1_B,
  },
  {
    LAMP_TARGET_1_E,
    LAMP_TARGET_1_A,
    LAMP_BONUS_2,
    LAMP_BONUS_2,
    LAMP_BONUS_2,
    LAMP_BONUS_2,
  },
  {
    LAMP_TARGET_1_R,
    LAMP_BONUS_1,
    LAMP_BONUS_5,
    LAMP_BONUS_5,
    LAMP_BONUS_5,
    LAMP_BONUS_5,
  },    
  {
    LAMP_BONUS_3,
    LAMP_BONUS_3,
    LAMP_BONUS_3,
    LAMP_BONUS_3,
    LAMP_BONUS_3,
    LAMP_BONUS_3,
  },
  {
    LAMP_BONUS_6,
    LAMP_BONUS_6,
    LAMP_BONUS_6,
    LAMP_BONUS_6,
    LAMP_BONUS_6,
    LAMP_BONUS_6,
  },
  {
    LAMP_LANE_LEFT,
    LAMP_LANE_LEFT,
    LAMP_LANE_LEFT,
    LAMP_LANE_LEFT,
    LAMP_LANE_LEFT,
    LAMP_LANE_LEFT,
  },
  {
    LAMP_TARGET_2_L,
    LAMP_TARGET_2_O,
    LAMP_TARGET_2_G,
    LAMP_TARGET_2_J,
    LAMP_TARGET_2_A,
    LAMP_TARGET_2_M,
  },
  {
    LAMP_LANE_RIGHT,
    LAMP_LANE_RIGHT,
    LAMP_LANE_RIGHT,
    LAMP_LANE_RIGHT,
    LAMP_LANE_RIGHT,
    LAMP_LANE_RIGHT,
  }
};


void attractLamps(timerEvent id, uint16_t state)
{
  static uint8_t stateCount;
  static uint8_t stateRepeat;

  switch(state)
  {
    case 0: 
      stateCount = 0;
      stateRepeat = 0;
      setLampMode( LAMP_BACKBOX_BEAR_3, LAMP_FLASH_STATE, QUARTER_SECOND, 4 );
      setTimer(ATTRACT_LAMP_TMR, ONE_HUNDRETH_SECOND, ++state);
      break;

    case 1:
      // round cycles through all lights on playfield, 
      // double-flash creates chasing effect
      setTimer(ATTRACT_LAMP_TMR, FIVE_HUNDRETH_SECONDS, state);
      setLampMode(stateCount++, LAMP_BLINK_STATE, QUARTER_SECOND, 3 );
      if(stateCount > LAMP_LAST_PLAYFIELD) {
        stateCount = 0;
        if ( stateRepeat++ > 2 ) {
          stateCount = 0;
          stateRepeat = 0;
          setTimer(ATTRACT_LAMP_TMR, QUARTER_SECOND, ++state);
        }
      }
      break;

    case 2:
      // left to right and back, mostly off
      setTimer(ATTRACT_LAMP_TMR, FIVE_HUNDRETH_SECONDS, state);
      for (uint8_t i=0; i<6; i++) {
        lamp light;
        if ( (stateRepeat & 0x01) == 0 ){
          light = pgm_read_byte(&horizLamps[stateCount][i]);
        } else {
          light = pgm_read_byte(&horizLamps[10-stateCount][i]);
        }
        setLampMode( light, LAMP_BLINK_ON_STATE, QUARTER_SECOND, 1 );
      }
      if ( stateCount++ >= 10 ) {
        stateCount = 0;
        if ( stateRepeat++ > 4 ) {
          stateRepeat = 0;
          setTimer(ATTRACT_LAMP_TMR, ONE_HUNDRETH_SECOND, ++state);
        }
      }
      break;
      
    case 3:
      // all on
      for (uint8_t i=0; i<=LAMP_LAST_PLAYFIELD; i++) {
        setLampMode( i, LAMP_ON_STATE, 0, INFINITE );
      }
      setTimer(ATTRACT_LAMP_TMR, ONE_HUNDRETH_SECOND, ++state);
      stateCount = 0;
      break;      
      
    case 4:
      // super fast round cycles through all lights on playfield
      // mostly on
      setTimer(ATTRACT_LAMP_TMR, ONE_HUNDRETH_SECOND, state);
      setLampMode(stateCount++, LAMP_FLASH_STATE, EIGTH_SECOND, 1 );
      if(stateCount > LAMP_LAST_PLAYFIELD) {
        stateCount = 0;
        if ( stateRepeat++ > 3 ) {
          stateCount = 0;
          stateRepeat = 0;
          setTimer(ATTRACT_LAMP_TMR, QUARTER_SECOND, ++state);
        }
      }
      break;

    case 5:
      // top to bottom and back, mostly off
      setTimer(ATTRACT_LAMP_TMR, FIVE_HUNDRETH_SECONDS, state);
      for (uint8_t i=0; i<3; i++) {
        lamp light;
        if ( (stateRepeat & 0x01) == 0 ){
          light = pgm_read_byte(&vertLamps[stateCount][i]);
        } else {
          light = pgm_read_byte(&vertLamps[14-stateCount][i]);
        }
        setLampMode( light, LAMP_BLINK_ON_STATE, QUARTER_SECOND, 1 );
      }
      if ( stateCount++ >= 14 ) {
        stateCount = 0;
        if ( stateRepeat++ > 4 ) {
          stateRepeat = 0;
          setTimer(ATTRACT_LAMP_TMR, ONE_HUNDRETH_SECOND, ++state);
        }
      }
      break;

    case 6:
      // all on
      for (uint8_t i=0; i<=LAMP_LAST_PLAYFIELD; i++) {
        setLampMode( i, LAMP_ON_STATE, 0, INFINITE );
      }
      setTimer(ATTRACT_LAMP_TMR, ONE_HUNDRETH_SECOND, 0/*state*/);
      stateCount = 0;
      break;      

  }
}


// cycles display through attract states
void attractTimer(timerEvent id, uint16_t state)
{
  static uint8_t cycles = 0;

  if(gameOn) return;

  switch(state) {
  case ATTRACT_PLAY:
    displayText("play");
    setTimer(ATTRACT_TMR, ONE_SECOND, ATTRACT_PINBALL);
    cycles = 0;
    break;
  case ATTRACT_PINBALL:
    if(cycles == 0) cycles = 8;
    if(--cycles) {
      displayView( 3, cycles );
      displayText( "pinball" );
      setTimer(ATTRACT_TMR, ONE_HUNDRETH_SECOND, ATTRACT_PINBALL);    
    } else {
      setTimer(ATTRACT_TMR, ONE_SECOND, ATTRACT_SCORE);
    }
    break;
  case ATTRACT_SCORE:
    displayScore( 0 );
    setTimer(ATTRACT_TMR, FIVE_SECONDS, ATTRACT_HIGH_SCORE);
    break;
  case ATTRACT_HIGH_SCORE:
    displayText( "hi score" );
    setTimer(ATTRACT_TMR, ONE_SECOND, ATTRACT_HIGH_SCORE_1);
    break;
  case ATTRACT_HIGH_SCORE_1:
    displayText( "%ld", nonVolatiles.highScore );
    setTimer(ATTRACT_TMR, THREE_SECONDS, ATTRACT_GAME_OVER);
    break;
  case ATTRACT_GAME_OVER:
    displayText( "GameOver" );
    setTimer(ATTRACT_TMR, ONE_SECOND, ATTRACT_CREDITS);    
    break;
  case ATTRACT_CREDITS:
    if ( nonVolatiles.coinsPerGame > 0 ) {
      displayText( "coins" );
      setTimer(ATTRACT_TMR, ONE_SECOND, ATTRACT_CREDITS_1);
    } else {
      setTimer(ATTRACT_TMR, ONE_HUNDRETH_SECOND, ATTRACT_PLAY);
    }
    break;
  case ATTRACT_CREDITS_1:
    displayText("%d of %d", credits, nonVolatiles.coinsPerGame );
    setTimer(ATTRACT_TMR, ONE_SECOND, ATTRACT_PLAY);
    break;
  case ATTRACT_INSERT_COINS:
    displayText("%d of %d", credits, nonVolatiles.coinsPerGame );
    setTimer(ATTRACT_TMR, ONE_SECOND, ATTRACT_INSERT_COINS_1);
    break;
  case ATTRACT_INSERT_COINS_1:
    displayText( "insert");
    setTimer(ATTRACT_TMR, ONE_SECOND, ATTRACT_INSERT_COINS_2);
    break;
  case ATTRACT_INSERT_COINS_2:
    displayText( "coins" );
    setTimer(ATTRACT_TMR, ONE_SECOND, ATTRACT_BLANK);
    break;
  case ATTRACT_BLANK:
    clearDisplay();
    setTimer(ATTRACT_TMR, ONE_SECOND, ATTRACT_PLAY);
    break;
  case ATTRACT_FREE: 
    displayText( "freegame" );
    setTimer(ATTRACT_TMR, ONE_HUNDRETH_SECOND, ATTRACT_SCORE);
    break;
  }
}


void cancelBoxTimer(void)
{
  cancelTimer( BOX_TMR );
  setLampMode( LAMP_BACKBOX_BEAR_1, LAMP_ON_STATE, 0, INFINITE );
  setLampMode( LAMP_BACKBOX_BEAR_2, LAMP_ON_STATE, 0, INFINITE );
  setLampMode( LAMP_BACKBOX_BEAR_3, LAMP_ON_STATE, 0, INFINITE );
} 


void boxTimer(timerEvent evt, uint16_t state)
{
  switch ( state )
  {
    case 0:
      setLampMode( LAMP_BACKBOX_BEAR_3, LAMP_ON_STATE, 0, INFINITE );
      setLampMode( LAMP_BACKBOX_BEAR_1, LAMP_OFF_STATE, 0, INFINITE );
      state++;
      break;
    case 1:
      setLampMode( LAMP_BACKBOX_BEAR_1, LAMP_ON_STATE, 0, INFINITE );
      setLampMode( LAMP_BACKBOX_BEAR_2, LAMP_OFF_STATE, 0, INFINITE );
      state++;
      break;
    case 2:
      setLampMode( LAMP_BACKBOX_BEAR_2, LAMP_ON_STATE, 0, INFINITE );
      setLampMode( LAMP_BACKBOX_BEAR_3, LAMP_OFF_STATE, 0, INFINITE );
      state=0;
      break;
  }

  setTimer( BOX_TMR, FIVE_HUNDRETH_SECONDS, state );
}


void crazyModeTimer(timerEvent id, uint16_t state)
{
  if (state++>4) {
    state = 0;
  }
  setLampMode( LAMP_BONUS_1 + state, LAMP_BLINK_STATE, EIGTH_SECOND, 3 );
  setTimer(CRAZY_TMR, TEN_HUNDRETH_SECONDS, state);
}


void spinTimer(timerEvent id, uint16_t state)
{
  static uint8_t countDown = 0;
  static uint8_t count = 0;
  
  if ( (state==0) && (countDown==0) ) {
    playSound( SOUND_SPINNER );
  }
  
  if ( state > 0 ) {
    if ( countDown < 4 ) {
      countDown++;
    }
  }
  
  setLampMode( LAMP_RIVER_ARROW_1 + count, LAMP_BLINK_ON_STATE, TEN_HUNDRETH_SECONDS, 2 );

  setTimer(SPIN_TMR, FOUR_HUNDRETH_SECONDS, 0);

  if ( count++ > 4 ) {
    count = 0;
    if ( --countDown == 0 ) {
      cancelTimer(SPIN_TMR);
      // shoot the blinking light
      setLampMode(LAMP_RIVER_ARROW_1, LAMP_BLINK_ON_STATE, EIGTH_SECOND, INFINITE);
    }
  }
}



void gameTimer(timerEvent id, uint16_t state)
{
  if(!gameOn) return;

  switch(state) {
  case GAME_BALL_LOAD:
    ballIsLoading = TRUE;
    playSound( SOUND_MAIN_MUSIC );
    hitSolenoid( SOLENOID_BALL_LOADER );
    displayText( "ball %d", ballInPlay );
    setTimer(GAME_TMR, TWO_SECONDS, GAME_SCORE);
    break;    
  case GAME_BALL_AGAIN:
    hitSolenoid( SOLENOID_BALL_LOADER );
    displayText( "shoot" );
    setTimer(GAME_TMR, ONE_SECOND, GAME_BALL_AGAIN_1);
    break;
  case GAME_BALL_AGAIN_1:
    displayText( "again" );
    setTimer(GAME_TMR, ONE_SECOND, GAME_SCORE);
    break;
  case GAME_SCORE:
    scoreDisplayDisabled = FALSE;
    ballIsLoading = FALSE;
    displayScore( 0 );
    break;
  case GAME_FREE_CREDIT:
    scoreDisplayDisabled = TRUE;
    displayText( "freegame" );
    setTimer(GAME_TMR, TWO_SECONDS, GAME_SCORE);
    break;
  case GAME_TILT:
    scoreDisplayDisabled = TRUE;
    setTimer(BEAR_TMR, ONE_SECOND, BEAR_CLOSE); //BEAR_EJECT
    for (int i=0; i<=LAMP_LAST; i++) {
      setLampMode( i, LAMP_OFF_STATE, 0, INFINITE );
    }
    setLampMode( LAMP_PLAYFIELD_GI, LAMP_FLASH_STATE, THREE_SECONDS, 1 );
    setLampMode( LAMP_BACKBOX_TILT, LAMP_ON_STATE, 0, INFINITE );
    playSound( SOUND_GAME_TILT );
    flipperEnableSolenoids( false );
    displayText( "tilt" );
    setTimer(GAME_TMR, THREE_SECONDS, GAME_BALL_WAIT);
    break;
  case GAME_BALL_WAIT:
  default:
    break;
  }
}

// cycles the bear through its various motions
//   modes are activated by "BEAR" targets and bear capture
void bearTimer(timerEvent id, uint16_t state)
{
  static uint8_t cycles=0;

  switch(state) {
  case BEAR_OPEN:
    playSound( SOUND_BEAR_OPEN );
    playSound( SOUND_BEAR_MUSIC );
    setLampMode( LAMP_BEAR_ARROW, LAMP_BLINK_STATE, EIGTH_SECOND, INFINITE );
    setLampMode( LAMP_BEAR_MOUTH, LAMP_BLINK_STATE, EIGTH_SECOND, INFINITE );
    // thru...
  case BEAR_HOLD_OPEN:
    bearSetPulse(nonVolatiles.headOpen);
    setTimer(BEAR_TMR, HALF_SECOND, BEAR_HOLD_OPEN);  // keep open
    break;
  case BEAR_CHEW:
    cycles = 6;
    // thru...
  case BEAR_CHEW_1:
    if ( cycles % 2 ) {
      bearSetPulse(nonVolatiles.headClose);
    } else {
      bearSetPulse(nonVolatiles.headOpen);
    }
    if(--cycles) {
      setTimer(BEAR_TMR, QUARTER_SECOND, BEAR_CHEW_1);
    } else {
      setTimer(BEAR_TMR, QUARTER_SECOND, BEAR_EJECT);
    }
    break;
  case BEAR_EJECT:
    bearSetPulse(nonVolatiles.headOpen);
    setTimer(BEAR_TMR, HALF_SECOND, BEAR_EJECT_1);
    break;
  case BEAR_EJECT_1:
    hitSolenoid( SOLENOID_BEAR_CAPTURE );
    setTimer(BEAR_TMR, HALF_SECOND, BEAR_CLOSE);
    break;
  case BEAR_TEST:
    setTimer(BEAR_TMR, EIGTH_SECOND, BEAR_TEST);
    break;
  case BEAR_CLOSE:
    setLampMode( LAMP_BEAR_ARROW, LAMP_OFF_STATE, 0, INFINITE );
    setLampMode( LAMP_BEAR_MOUTH, LAMP_OFF_STATE, 0, INFINITE );
    // and back to shoot the blinking lights
    for(int i = LAMP_TARGET_1_B; i <= LAMP_TARGET_1_R; i++) {
      setLampMode(i, LAMP_BLINK_ON_STATE, EIGTH_SECOND, INFINITE);
    }
    if (!tilt) { playSound( SOUND_MAIN_MUSIC ); }
    // thru...
  case BEAR_HOLD_CLOSE:
  default:
    bearSetPulse(nonVolatiles.headClose);
    setTimer(BEAR_TMR, EIGTH_SECOND, BEAR_HOLD_CLOSE);  // keep closed
    break;
  }
}


void startGame(void)
{
  resetScore();
  gameOn = TRUE;
  highScoreExceeded = FALSE;
  ballInPlay = 0;
  multiplier = 1;
  crazyMode = FALSE;

  cancelTimer(ATTRACT_TMR);
  cancelTimer(ATTRACT_LAMP_TMR);
  setLampMode( LAMP_BACKBOX_GAME_OVER, LAMP_OFF_STATE, 0, INFINITE );
  setLampMode( LAMP_START_BUTTON, LAMP_ON_STATE, 0, INFINITE );

  for (uint8_t i=0; i<LAMP_QTY; i++) {
    setLampMode(i, LAMP_OFF_STATE, 0, 1);
  }

  nextBall();
}

void nextBall(void)
{
  tilt = FALSE;
  tiltSense = 0;
  flipperEnableSolenoids( true );

  setLampMode( LAMP_BACKBOX_TILT, LAMP_OFF_STATE, 0, INFINITE );
  setLampMode( LAMP_BACKBOX_BEAR_1, LAMP_ON_STATE, 0, INFINITE );
  setLampMode( LAMP_BACKBOX_BEAR_2, LAMP_ON_STATE, 0, INFINITE );
  setLampMode( LAMP_BACKBOX_BEAR_3, LAMP_ON_STATE, 0, INFINITE );
  setLampMode( LAMP_PLAYFIELD_GI, LAMP_ON_STATE, 0, INFINITE );
  setLampMode( LAMP_POP_BUMPER_UPPER, LAMP_ON_STATE, 0, INFINITE );
  setLampMode( LAMP_POP_BUMPER_LOWER, LAMP_ON_STATE, 0, INFINITE );
  
  // shoot the blinking lights
  lamp lamps[] = { LAMP_RIVER_ARROW_1, 
                   LAMP_TARGET_1_B, LAMP_TARGET_1_E, LAMP_TARGET_1_A, LAMP_TARGET_1_R,
                   LAMP_TARGET_2_L, LAMP_TARGET_2_O, LAMP_TARGET_2_G, LAMP_TARGET_2_J, LAMP_TARGET_2_A, LAMP_TARGET_2_M };
  for (int i=0; i<sizeof(lamps)/sizeof(lamps[0]); i++) {
    if ( getLampMode( lamps[i] ) == LAMP_OFF_STATE ) {
      setLampMode(lamps[i], LAMP_BLINK_ON_STATE, EIGTH_SECOND, INFINITE);
    }
  }
  // shoot the blinking light
  for (int i=LAMP_BONUS_1; i<LAMP_BONUS_1+multiplier; i++) {
    if ( (getLampMode(i) == LAMP_OFF_STATE) ) {
      setLampMode(i, LAMP_ON_STATE, INFINITE, 1);
    }
  }
  if ( (getLampMode(LAMP_BONUS_1 + multiplier) != LAMP_BLINK_ON_STATE) ) {
    setLampMode(LAMP_BONUS_1 + multiplier, LAMP_BLINK_ON_STATE, EIGTH_SECOND, INFINITE);
  }

  if (ballInPlay++ < nonVolatiles.ballsPerGame) {
    playSound( SOUND_DRAIN );
    setTimer(GAME_TMR, ONE_HUNDRETH_SECOND, GAME_BALL_LOAD);
  } else {
    gameOver();
    playSound( SOUND_GAME_END );
  }
}

void gameOver(void)
{
  if ( highScoreExceeded ) {
    nonVolatiles.freeGameHighScore++;
    increaseCredits( nonVolatiles.coinsPerGame, FALSE );
    nonVolatiles.highScore = score;
    saveNonVolatiles();
  }

  gameOn = FALSE;

  flipperEnableSolenoids( false );

  for (uint8_t i=0; i<LAMP_QTY; i++) {
    setLampMode(i, LAMP_OFF_STATE, 0, 1);
  }

  setLampMode( LAMP_BACKBOX_GAME_OVER, LAMP_ON_STATE, 0, INFINITE );
  setLampMode( LAMP_PLAYFIELD_GI, LAMP_ON_STATE, 0, INFINITE );
  setLampMode( LAMP_BACKBOX_RIVER, LAMP_ON_STATE, 0, INFINITE );
  setLampMode( LAMP_BACKBOX_CABIN, LAMP_ON_STATE, 0, INFINITE );
  setLampMode( LAMP_START_BUTTON, LAMP_BLINK_STATE, HALF_SECOND, INFINITE );
    
  cancelTimer(CRAZY_TMR);
  cancelBoxTimer();
  setTimer(BEAR_TMR, QUARTER_SECOND, BEAR_CLOSE);
  setTimer(ATTRACT_TMR, ONE_HUNDRETH_SECOND, ATTRACT_PLAY);
  setTimer(ATTRACT_LAMP_TMR, ONE_HUNDRETH_SECOND, 0);
}


//////////////////////////////////
// credits
//////////////////////////////////
void increaseCredits(uint8_t value, boolean coinMode)
{
  credits += value;
  if  (credits > 99) credits = 99;
  if (coinMode ) {
    hitSolenoid( SOLENOID_WOODBLOCK );
    setIfActiveTimer(ATTRACT_TMR, ATTRACT_CREDITS_1);  
  }
}

boolean decreaseCredits(void)
{
  nonVolatiles.gamesPlayed++;
  
  if ( credits < nonVolatiles.coinsPerGame ) 
    return FALSE;
  
  credits -= nonVolatiles.coinsPerGame;
  return TRUE;
}


//////////////////////////////////
// scoring and non volatiles
//////////////////////////////////

static uint8_t checkCalc( uint8_t sum, uint8_t *data, uint8_t size )
{
  uint8_t i;
  for (i=0; i<size; i++) {
    sum += data[ i ];
  }
  return sum;
}

void resetNonVolatiles(void)
{
  nonVolatiles_t nv = {
    .highScore = 50000,
    .headOpen = 20,
    .headClose = 25,
    .quiteMode = 1,
    .tiltSensitivity = 3,
    .ballsPerGame = 3,
    .soundBoard = 1,
    .coinsPerGame = 0,
    .gamesPlayed = 0, // stats
    .freeGameMatch = 0, // stats
    .freeGameHighScore = 0, // stats
    .checkSum = 0
  };
  memcpy( &nonVolatiles, &nv, sizeof(nv) );
}

void loadNonVolatiles(void)
{
  uint8_t sum;
  eeprom_read_block( (uint8_t*)&nonVolatiles, (uint8_t*)0, sizeof(nonVolatiles) );
  sum = checkCalc( 0, (uint8_t*)&nonVolatiles, sizeof(nonVolatiles) - sizeof(nonVolatiles.checkSum ) );
  if ( sum != nonVolatiles.checkSum ) {
    resetNonVolatiles();
  }
}

void saveNonVolatiles(void) 
{
  nonVolatiles.checkSum = 
      checkCalc( 0, (uint8_t*)&nonVolatiles, sizeof(nonVolatiles) - sizeof(nonVolatiles.checkSum ) );
  eeprom_write_block( (uint8_t*)&nonVolatiles, (uint8_t*)0, sizeof(nonVolatiles) );
}


void displayScore(uint8_t color)
{
  extern uint8_t invertDisplayColors;
  invertDisplayColors = color;

  char s[12] = {0,};
  sprintf(s,"%ld", score);
  displayText("%6s", s);
}

void resetScore(void)
{
  score = 0;
  displayScore( 0 );
}

uint32_t getScore(void)
{
  return score;
}

void increaseScore(uint16_t value)
{
  score += value * multiplier;

  if ( !scoreDisplayDisabled ) {
    displayScore( 0xff );  
  }
  
  if ( !highScoreExceeded )
  {
    if ( score > nonVolatiles.highScore )
    {
      highScoreExceeded = TRUE;
      setTimer(GAME_TMR, ONE_HUNDRETH_SECOND, GAME_FREE_CREDIT);
      hitSolenoid( SOLENOID_KNOCKER );
    }
  }
}


void configMode(slowSwitch sw)
{
  typedef enum {
    modeNone = 0,
    modeBalls = 1,
    modeCoins = 2,
    modeStats_1 = 3,
    modeStats_2 = 4,
    modeStats_3 = 5,
    modeQuiet = 6,
    modeSound = 7,
    modeTiltSensitivity = 8,
    modeHeadOpen = 9,
    modeHeadClose = 10,
    modeReset = 11,
    maxModes = 11
  } configModes_t;
  
  static configModes_t mode = 0;

  switch(sw) {
    case SWITCH_TEST_ENTER:
      if ( mode == 0 ) {
        cancelTimer(BEAR_TMR);
        cancelTimer(ATTRACT_TMR);
        cancelTimer(ATTRACT_LAMP_TMR);
        cancelTimer(GAME_TMR);
      } 
      if ( ++mode > maxModes ) {
        mode = 1;
      }
      break;
    case SWITCH_TEST_ESCAPE:
      mode = 0;
      saveNonVolatiles();
      gameOver();
      break;
    case SWITCH_TEST_PLUS:
      switch(mode) {
        case modeHeadOpen:
          if (nonVolatiles.headOpen<31)
            nonVolatiles.headOpen++;
          break;
        case modeHeadClose:
          if (nonVolatiles.headClose<31)
            nonVolatiles.headClose++;
          break;
        case modeQuiet:
          if (nonVolatiles.quiteMode<2)
            nonVolatiles.quiteMode++;
          break;
        case modeSound:
          nonVolatiles.soundBoard = 1;
          break;
        case modeTiltSensitivity:
          if (nonVolatiles.tiltSensitivity<99)
            nonVolatiles.tiltSensitivity++;
          break;
        case modeBalls:
          if (nonVolatiles.ballsPerGame<9)
            nonVolatiles.ballsPerGame++;
          break;
        case modeCoins:
          if (nonVolatiles.coinsPerGame<9)
            nonVolatiles.coinsPerGame++;
          break;
        case modeReset:
          hitSolenoid( SOLENOID_KNOCKER );
          resetNonVolatiles();
          break;
        default:
          break;
      }
      break;
    case SWITCH_TEST_MINUS:
      switch(mode) {
        case modeHeadOpen:
          if (nonVolatiles.headOpen>15)
            nonVolatiles.headOpen--;
          break;
        case modeHeadClose:
          if (nonVolatiles.headClose>15)
            nonVolatiles.headClose--;
          break;
        case modeQuiet:
          if (nonVolatiles.quiteMode>0)
            nonVolatiles.quiteMode--;
          break;
        case modeSound:
          nonVolatiles.soundBoard = 0;
          break;
        case modeTiltSensitivity:
          if (nonVolatiles.tiltSensitivity > 1)
            nonVolatiles.tiltSensitivity--;
          break;
        case modeBalls:
          if (nonVolatiles.ballsPerGame > 1)
            nonVolatiles.ballsPerGame--;
          break;
        case modeCoins:
          if (nonVolatiles.coinsPerGame > 0)
            nonVolatiles.coinsPerGame--;
          break;
        default:
          break;
      }
      break;
    default:
      break;
  } 

  switch(mode) {
    case modeHeadOpen:
      bearSetPulse( nonVolatiles.headOpen );
      setTimer(BEAR_TMR, QUARTER_SECOND, BEAR_TEST);
      displayText("hdo %04d", nonVolatiles.headOpen );
      break;
    case modeHeadClose:
      bearSetPulse( nonVolatiles.headClose );
      setTimer(BEAR_TMR, QUARTER_SECOND, BEAR_TEST);
      displayText("hdc %04d", nonVolatiles.headClose );
      break;
    case modeQuiet:
      displayText("quiet %d", nonVolatiles.quiteMode );
      break;
    case modeTiltSensitivity:
      displayText("tilty %d", nonVolatiles.tiltSensitivity );
      break;
    case modeBalls:
      displayText("balls %d", nonVolatiles.ballsPerGame );
      break;
    case modeSound:
      displayText("sound %d", nonVolatiles.soundBoard );
      break;
    case modeCoins:
      displayText("coins %d", nonVolatiles.coinsPerGame );
      break;
    case modeStats_1:
      displayText("plays %d", nonVolatiles.gamesPlayed );
      break;
    case modeStats_2:
      displayText("fghs %d", nonVolatiles.freeGameHighScore );
      break;
    case modeStats_3:
      displayText("fgma %d", nonVolatiles.freeGameMatch );
      break;
    case modeReset:
      displayText("reset");
      break;
    default:
      break;
  }
}
