smdjeff/pinball-cabin-fever/software/timers.h

//      atmega-timers.h
//      
//      Copyright 2011 Javier Valencia <javiervalencia80@gmail.com>
//      
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
//      

#ifndef atmega_timers_h
#define atmega_timers_h

#ifdef __cplusplus
extern "C" {
#endif

#include <avr/io.h>
#include <avr/interrupt.h>

// Comment/delete those lines to disable interrupt definition for that timer
// so you can define your own ISR functions without conflicts.
//#define ENABLE_TIMER0_ISR
#define ENABLE_TIMER1_ISR
//#define ENABLE_TIMER2_ISR

#define TIMER0_PRESCALER_NONE 0
#define TIMER0_PRESCALER_1 1
#define TIMER0_PRESCALER_8 2
#define TIMER0_PRESCALER_64 3
#define TIMER0_PRESCALER_256 4
#define TIMER0_PRESCALER_1024 5

#define TIMER1_PRESCALER_NONE 0
#define TIMER1_PRESCALER_1 1
#define TIMER1_PRESCALER_8 2
#define TIMER1_PRESCALER_64 3
#define TIMER1_PRESCALER_256 4
#define TIMER1_PRESCALER_1024 5

#define TIMER2_PRESCALER_NONE 0
#define TIMER2_PRESCALER_1 1
#define TIMER2_PRESCALER_8 2
#define TIMER2_PRESCALER_32 3
#define TIMER2_PRESCALER_64 4
#define TIMER2_PRESCALER_128 5
#define TIMER2_PRESCALER_256 6
#define TIMER2_PRESCALER_1024 7


void timer0(uint8_t prescaler, uint8_t ticks, void (*f)(void));
void timer1(uint8_t prescaler, uint16_t ticks, void (*f)(void));
void timer2(uint8_t prescaler, uint8_t ticks, void (*f)(void));
void timer0_stop(void);
void timer1_stop(void);
void timer2_stop(void);

void wait0(uint8_t prescaler, uint8_t ticks);
void wait1(uint8_t prescaler, uint16_t ticks);
void wait2(uint8_t prescaler, uint8_t ticks);

#ifdef __cplusplus
}
#endif

#endif
