smdjeff/pinball-cabin-fever/(commit log)

2021-07-04 fix programmer settings and prog_mem attribute
    [tweenpin.c]
2021-07-04 bug fix and comment changes. set default high score to 50,000 turn off more lights including bear in backbox during tilt
    [slowswitch.c, solenoid.c, tweenpin.c, tweenpin.h]
2022-04-02 use real pwm for bear control.
2022-11-27 use real pwm for flippers and bear head servo
    [fastswitch.c, timer.c, timers.c, timers.h, tweenpin.h]
2022-11-27 use real spi driver for io exanders
2022-11-27 simplify solenoid and lamp drivers
2022-11-27 add sound drivers
2022-11-27 Pin adjustments for mega1284
2022-12-28 fix up the font a bit.
    [display.c, ht16k33.c]
2022-12-29 invert the display during scoring. use the woodblock a lot less. turn music back on and get game over music working right. simplify a few things - like match mode, and bear head.
    [fastswitch.c, ht16k33.c, slowswitch.c, solenoid.c, sound.c, timer.c, tweenpin.c, tweenpin.h]
